VidPavlovic/Diplomski/Tehnicki_crtezi/2-VP-DIP-00-01-01-01-00.pdf

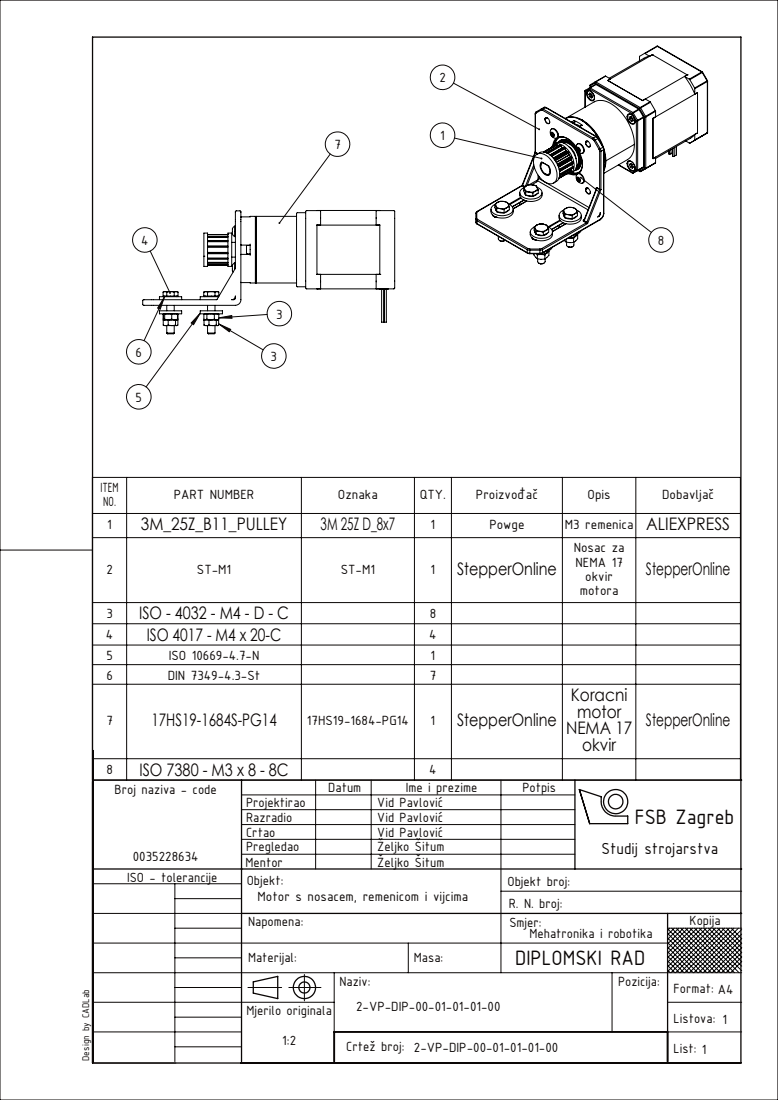
[picture p1: page 1]
Mehatronika i robotika; R. N. broj:

ITEM NO. | PART NUMBER | Oznaka | QTY. | Proizvođač | Opis | Dobavljač
1 | 3M_25Z_B11_PULLEY | 3M 25Z D_8x7 | 1 | Powge | M3 remenica | ALIEXPRESS
2 | ST-M1 | ST-M1 | 1 | StepperOnline | Nosac za NEMA 17 okvir motora | StepperOnline

3 | ISO - 4032 - M4 - D - C | | 8
4 | ISO 4017 - M4 x 20-C | | 4
5 | ISO 10669-4.7-N | | 1
6 | DIN 7349-4.3-St | | 7
7 | 17HS19-1684S-PG14 | 17HS19-1684-PG14 | 1 | StepperOnline | Koracni motor NEMA 17 okvir | StepperOnline

8 | ISO 7380 - M3 x 8 - 8C | | 4
Broj naziva - code 0035228634 | | Datum | Ime i prezime | Potpis | Studij strojarstva

Projektirao | | Vid Pavlović
Razradio | | Vid Pavlović | | FSB Zagreb Crtao

Vid Pavlović

Pregledao | | Željko Šitum

Mentor | | Željko Šitum
ISO - tolerancije | Objekt: Motor s nosacem, remenicom i vijcima | | | Objekt broj:

Materijal: | Masa: | DIPLOMSKI RAD

Naziv: 2-VP-DIP-00-01-01-01-00 | Pozicija: | Format: A4

Design by CADLab

Mjerilo originala | | | | Listova: 1
2-VP-DIP-00-01-01-01-00 1:2 Crtež broj: | | List: 1
