VidPavlovic/Diplomski/Tehnicki_crtezi/2-VP-DIP-00-02-02-00.pdf

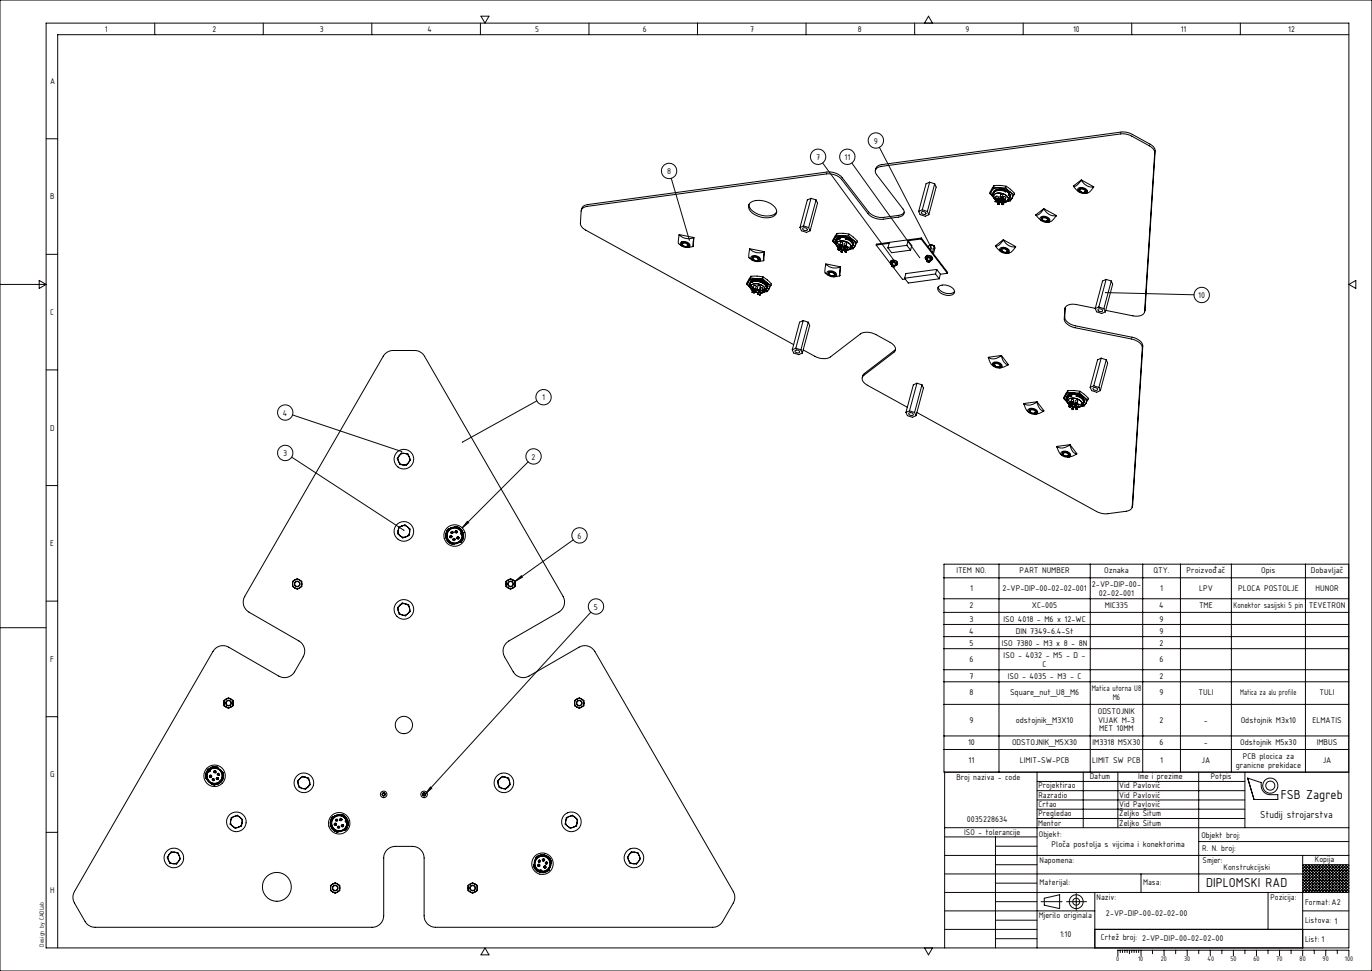
[picture p2: page 1]
Crtež broj:

ITEM NO. | 2-VP-DIP-00-02-02-001 PART NUMBER | 2-VP-DIP-00-Oznaka | QTY. | Proizvođač | Opis | Dobavljač 1

02-02-001 | 1 | LPV | PLOCA POSTOLJE | HUNOR

2 | XC-005 | MIC335 | 4 | TME | Konektor sasijski 5 pin | TEVETRON
3 | ISO 4018 - M6 x 12-WC | | 9
4 | DIN 7349-6.4-St | | 9
5 | ISO 7380 - M3 x 8 - 8N | | 2
6 | ISO - 4032 - M5 - D - C | | 6

7 | ISO - 4035 - M3 - C | | 2
8 | Square_nut_U8_M6 | Matica utorna U8 M6 | 9 | TULI | Matica za alu profile | TULI

9 | odstojnik_M3X10 | ODSTOJNIK VIJAK M-3 MET 10MM | 2 | - | Odstojnik M3x10 | ELMATIS

10 | ODSTOJNIK_M5X30 | IM3318 M5X30 | 6 | - | Odstojnik M5x30 | IMBUS
11 | LIMIT-SW-PCB | LIMIT SW PCB | 1 | JA | PCB plocica za granicne prekidace | JA
Broj naziva - code 0035228634 | Datum Ime i prezime Potpis Projektirao Vid Pavlović Razradio Vid Pavlović Crtao Vid Pavlović Pregledao Željko Šitum Mentor Željko Šitum | FSB Zagreb Studij strojarstva

ISO - tolerancije | Objekt: Objekt broj: Ploča postolja s vijcima i konektorima R. N. broj:

Napomena: Smjer: Konstrukcijski DIPLOMSKI RAD Materijal: Masa: Naziv: Pozicija: 2-VP-DIP-00-02-02-00 Mjerilo originala | Kopija Format: A21 Listova: List: 1

Design by CADLab
