VidPavlovic/Diplomski/Pneumatska_shema/2-VP-DIP-01.pdf

1 | 2 | 3 | 4

A

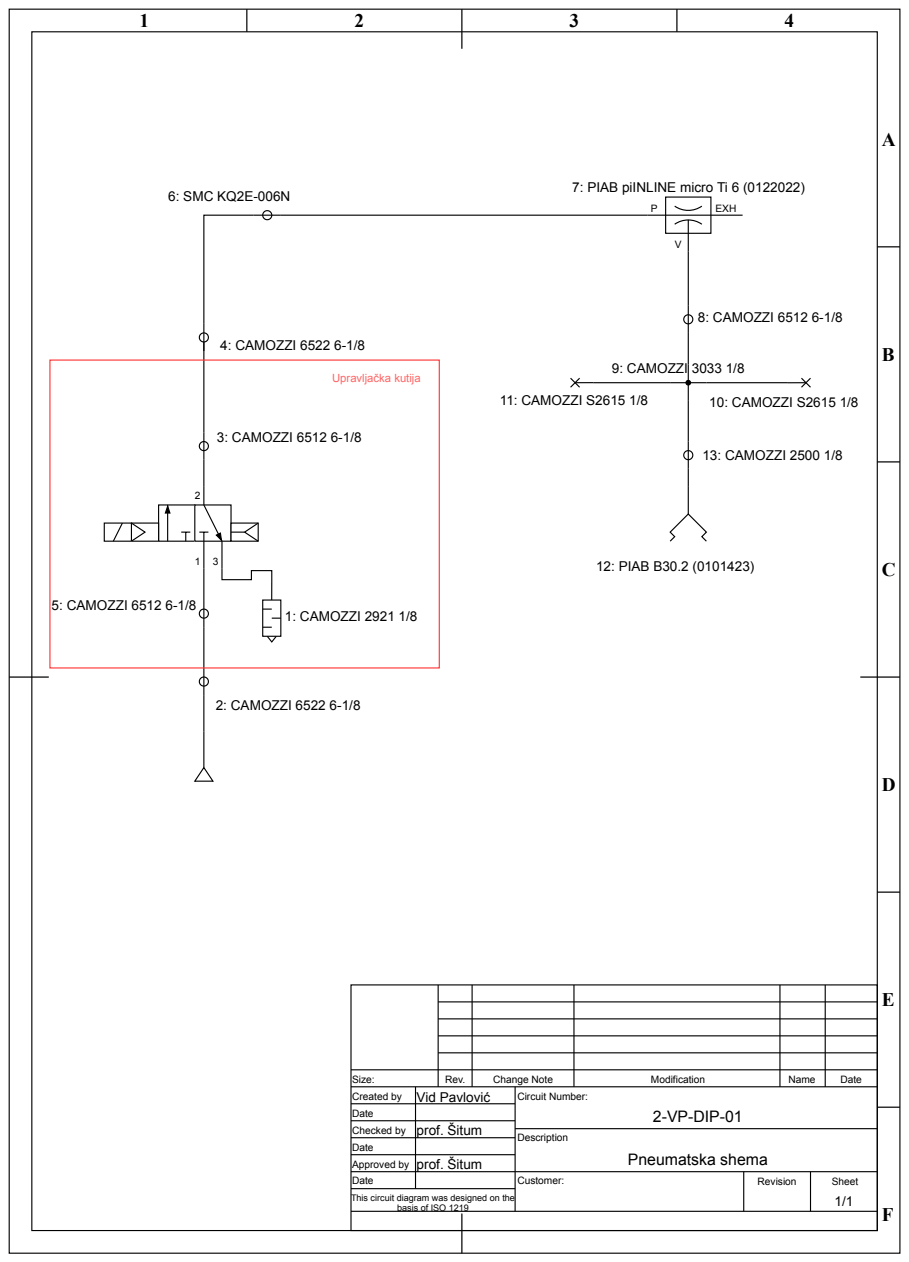
[picture p3: page 1]
Size:; Rev.; Change Note; Modification; Name; Date; Customer:; Description; Circuit Number:; Revision; Sheet; prof. Šitum; Vid Pavlović; Pneumatska shema; 2-VP-DIP-01; 2: CAMOZZI 6522 6-1/8; 5: CAMOZZI 6512 6-1/8; 3: CAMOZZI 6512 6-1/8; 4: CAMOZZI 6522 6-1/8; 6: SMC KQ2E-006N; EXH; 8: CAMOZZI 6512 6-1/8; 12: PIAB B30.2 (0101423); 9: CAMOZZI 3033 1/8; 10: CAMOZZI S2615 1/8; 1: CAMOZZI 2921 1/8; 11: CAMOZZI S2615 1/8; Upravljačka kutija; 13: CAMOZZI 2500 1/8

7: PIAB piINLINE micro Ti 6 (0122022)

Created by
Date
Checked by
Approved by
This circuit diagram was designed on the

basis of ISO 1219
