VidPavlovic/Diplomski/Tehnicki_crtezi/2-VP-DIP-00-01-00.pdf

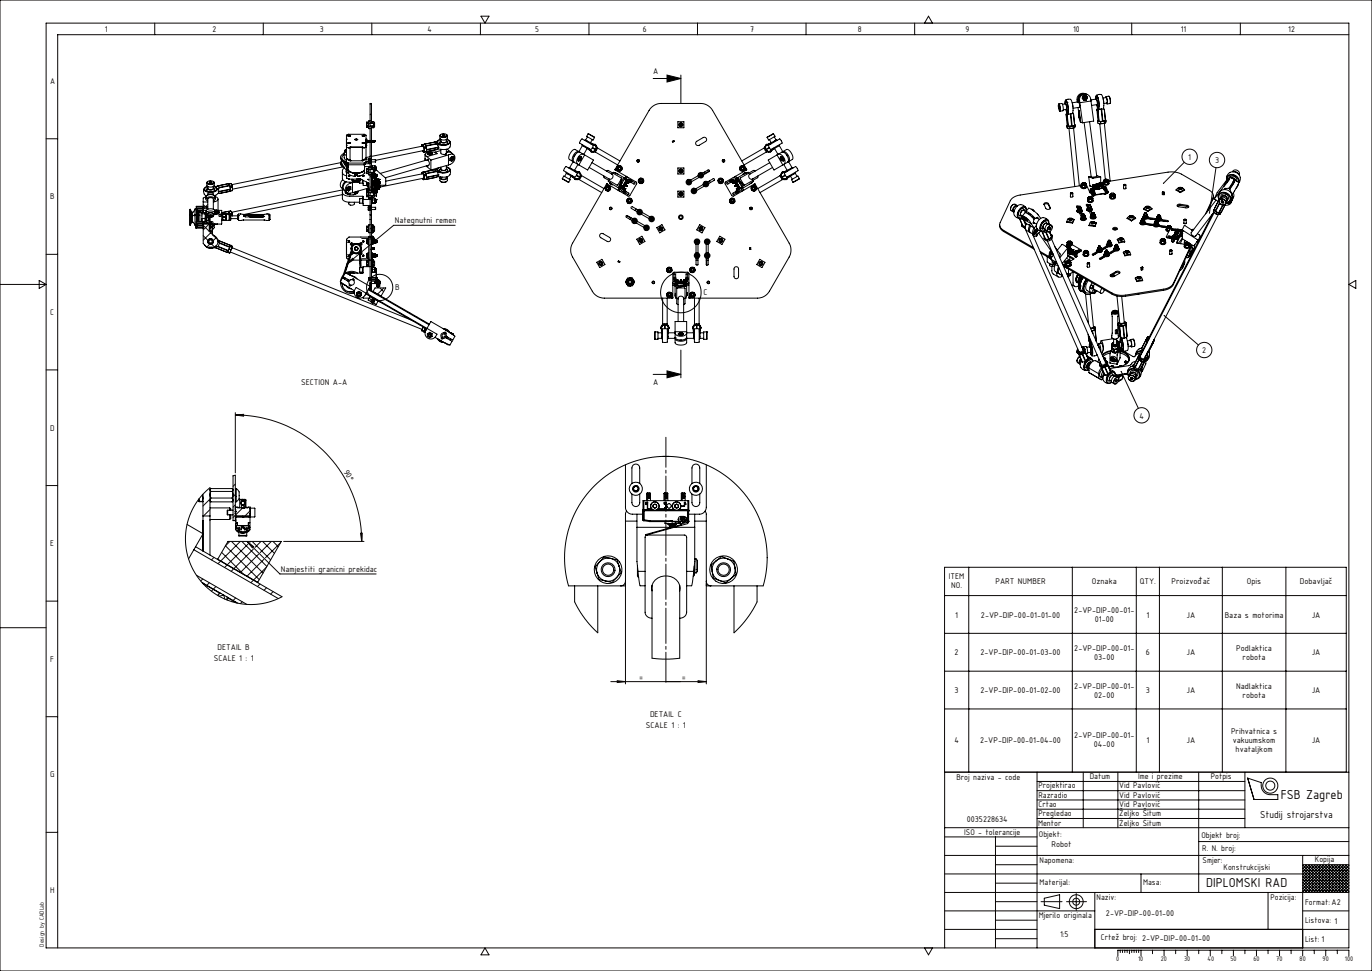
[picture p4: page 1]
SECTION A-A; Nategnutni remen; DETAIL B SCALE 1 : 1; DETAIL C SCALE 1 : 1; Crtež broj:; Mjerilo originala; DIPLOMSKI RAD

Namjestiti granicni prekidac

ITEM NO. | PART NUMBER | Oznaka | QTY. | Proizvođač | Opis | Dobavljač

1 | 2-VP-DIP-00-01-01-00 | 2-VP-DIP-00-01-01-00 | 1 | JA | Baza s motorima | JA

2 | 2-VP-DIP-00-01-03-00 | 2-VP-DIP-00-01-03-00 | 6 | JA | Podlaktica robota | JA

3 | 2-VP-DIP-00-01-02-00 | 2-VP-DIP-00-01-02-00 | 3 | JA | Nadlaktica robota | JA

4 | 2-VP-DIP-00-01-04-00 | 2-VP-DIP-00-01-04-00 | 1 | JA | Prihvatnica s vakuumskom hvataljkom | JA

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

ISO - tolerancije | Objekt: Objekt broj: Robot R. N. broj:

Design by CADLab
