VidPavlovic/Diplomski/Tehnicki_crtezi/2-VP-DIP-00-01-01-00.pdf

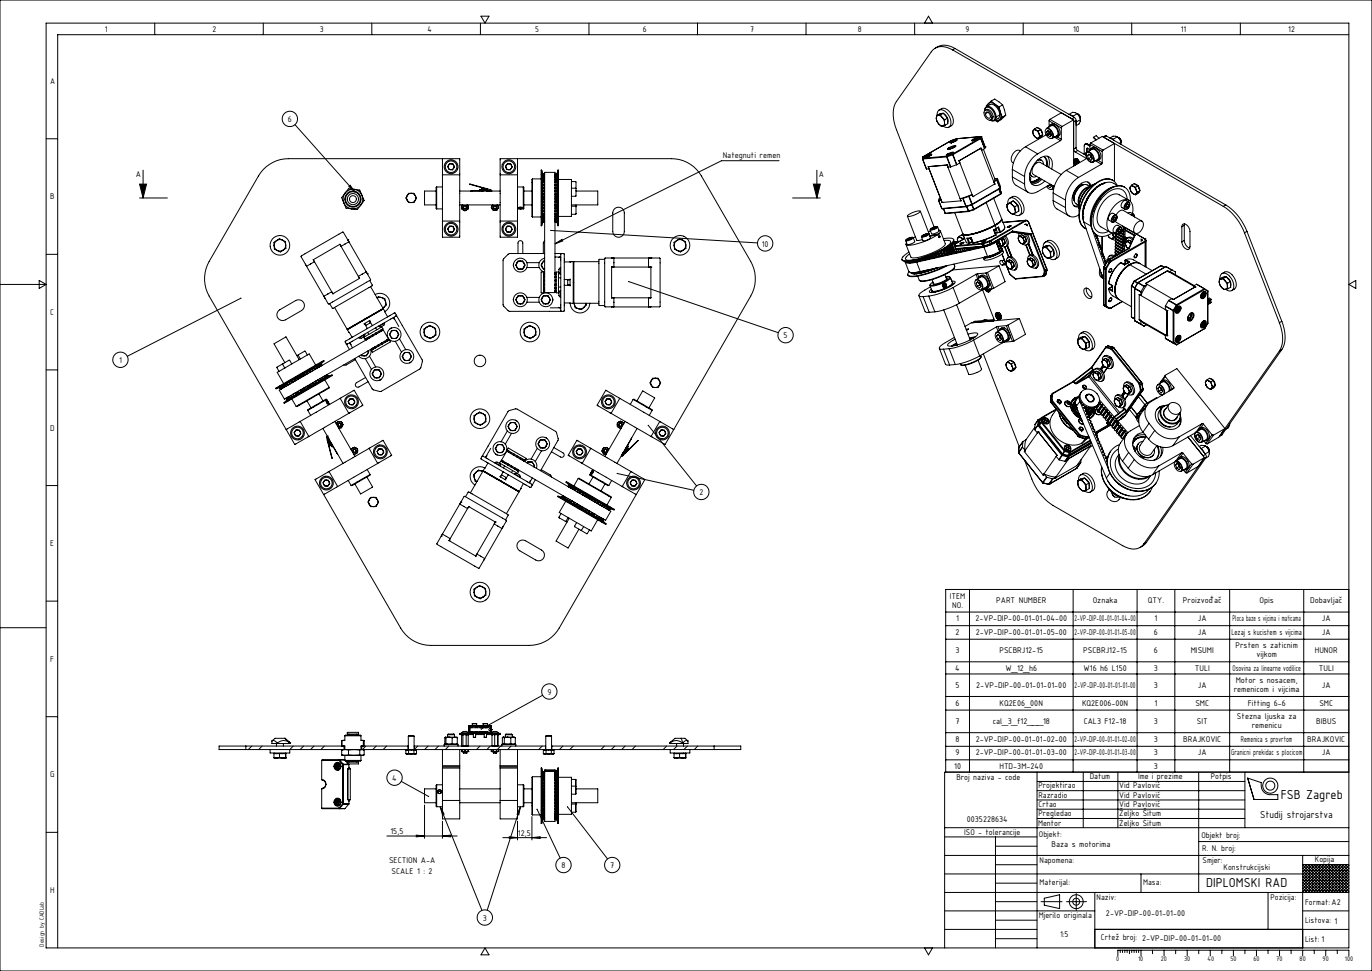
[picture p5: page 1]
Nategnuti remen; SECTION A-A SCALE 1 : 2; Crtež broj:; Mjerilo originala; DIPLOMSKI RAD

ITEM NO. | PART NUMBER | Oznaka | QTY. | Proizvođač | Opis | Dobavljač

1 | 2-VP-DIP-00-01-01-04-00 | 2-VP-DIP-00-01-01-04-00 | 1 | JA | Ploca baze s vijcima i maticama | JA
2 | 2-VP-DIP-00-01-01-05-00 | 2-VP-DIP-00-01-01-05-00 | 6 | JA | Lezaj s kucistem s vijcima | JA
3 | PSCBRJ12-15 | PSCBRJ12-15 | 6 | MISUMI | Prsten s zaticnim vijkom | HUNOR

4 | W_12_h6 | W16 h6 L150 | 3 | TULI | Osovina za linearne vodilice | TULI
5 | 2-VP-DIP-00-01-01-01-00 | 2-VP-DIP-00-01-01-01-00 | 3 | JA | Motor s nosacem, remenicom i vijcima | JA

6 | KQ2E06_00N | KQ2E006-00N | 1 | SMC | Fitting 6-6 | SMC
7 | cal_3_f12___18 | CAL3 F12-18 | 3 | SIT | Stezna ljuska za remenicu | BIBUS

8 | 2-VP-DIP-00-01-01-02-00 | 2-VP-DIP-00-01-01-02-00 | 3 | BRAJKOVIC | Remenica s provrtom | BRAJKOVIC
9 | 2-VP-DIP-00-01-01-03-00 | 2-VP-DIP-00-01-01-03-00 | 3 | JA | Granicni prekidac s plocicom | JA
10 | HTD-3M-240 | | 3
Broj naziva - code 0035228634 | Datum Ime i prezime Potpis Projektirao Vid Pavlović Razradio Vid Pavlović Crtao Vid Pavlović Pregledao Željko Šitum Mentor Željko Šitum | FSB Zagreb Studij strojarstva

ISO - tolerancije | Objekt: Objekt broj: Baza s motorima R. N. broj:

Design by CADLab
