VidPavlovic/Diplomski/Tehnicki_crtezi/2-VP-DIP-00-01-01-02-00.pdf

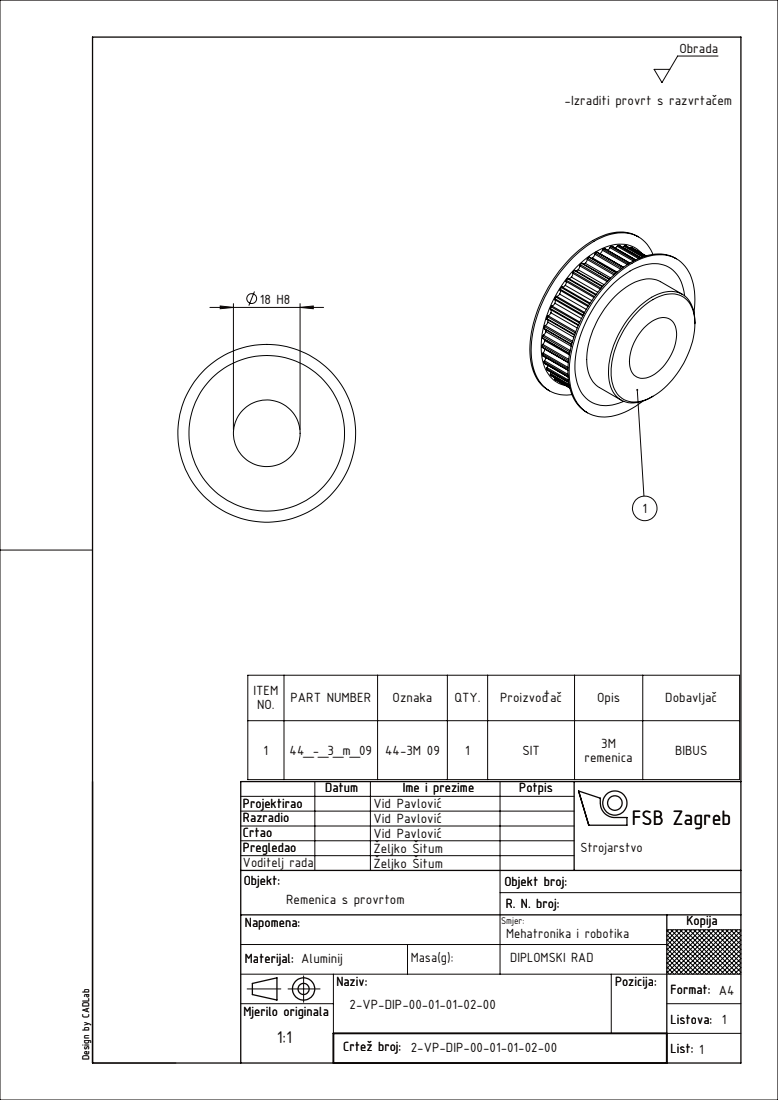
[picture p6: page 1]
R. N. broj:; Mehatronika i robotika

-Izraditi provrt s razvrtačem

ITEM NO. | PART NUMBER | Oznaka | QTY. | Proizvođač | Opis | Dobavljač

1 | 44_-_3_m_09 | 44-3M 09 | 1 | SIT | 3M remenica | BIBUS

Datum | Ime i prezime | Potpis | FSB Zagreb FSB Zagreb Strojarstvo
Projektirao | | Vid Pavlović
Razradio | | Vid Pavlović
Crtao | | Vid Pavlović
Pregledao | | Željko Šitum
Voditelj rada | | Željko Šitum
Objekt: Objekt: Remenica s provrtom | | | Objekt broj:

Materijal: Materijal: Aluminij | Masa(g): | DIPLOMSKI RAD

Naziv: Naziv: 2-VP-DIP-00-01-01-02-00 | Pozicija: | Format: Format: A4

Design by CADLab

Mjerilo originala | | | | Listova: Listova: 1
2-VP-DIP-00-01-01-02-00 1:1 Crtež broj: Crtež broj: | | List: List: 1
