VidPavlovic/Diplomski/Tehnicki_crtezi/2-VP-DIP-00-01-01-03-00.pdf

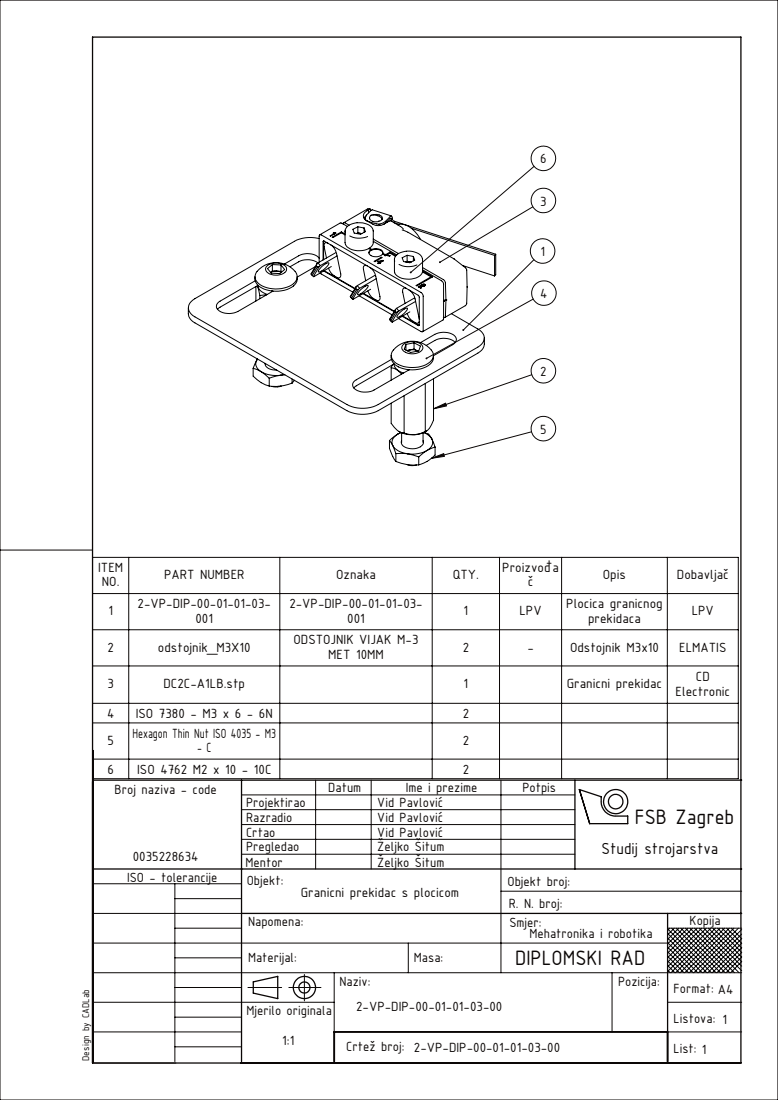
[picture p7: page 1]
Mehatronika i robotika; R. N. broj:

ITEM NO. | PART NUMBER | Oznaka | QTY. | Proizvođa č | Opis | Dobavljač

1 | 2-VP-DIP-00-01-01-03-001 | 2-VP-DIP-00-01-01-03-001 | 1 | LPV | Plocica granicnog prekidaca | LPV

2 | odstojnik_M3X10 | ODSTOJNIK VIJAK M-3 MET 10MM | 2 | - | Odstojnik M3x10 | ELMATIS

3 | DC2C-A1LB.stp | | 1 | | Granicni prekidac | CD Electronic

4 | ISO 7380 - M3 x 6 - 6N | | 2
5 | Hexagon Thin Nut ISO 4035 - M3 - C | | 2

6 | ISO 4762 M2 x 10 - 10C | | 2
Broj naziva - code 0035228634 | | Datum | Ime i prezime | Potpis | Studij strojarstva

Projektirao | | Vid Pavlović
Razradio | | Vid Pavlović | | FSB Zagreb Crtao

Vid Pavlović

Pregledao | | Željko Šitum

Mentor | | Željko Šitum
ISO - tolerancije | Objekt: Granicni prekidac s plocicom | | | Objekt broj:

Materijal: | Masa: | DIPLOMSKI RAD

Naziv: 2-VP-DIP-00-01-01-03-00 | Pozicija: | Format: A4

Design by CADLab

Mjerilo originala | | | | Listova: 1
2-VP-DIP-00-01-01-03-00 1:1 Crtež broj: | | List: 1
