VidPavlovic/Diplomski/Tehnicki_crtezi/2-VP-DIP-00-01-01-04-00.pdf

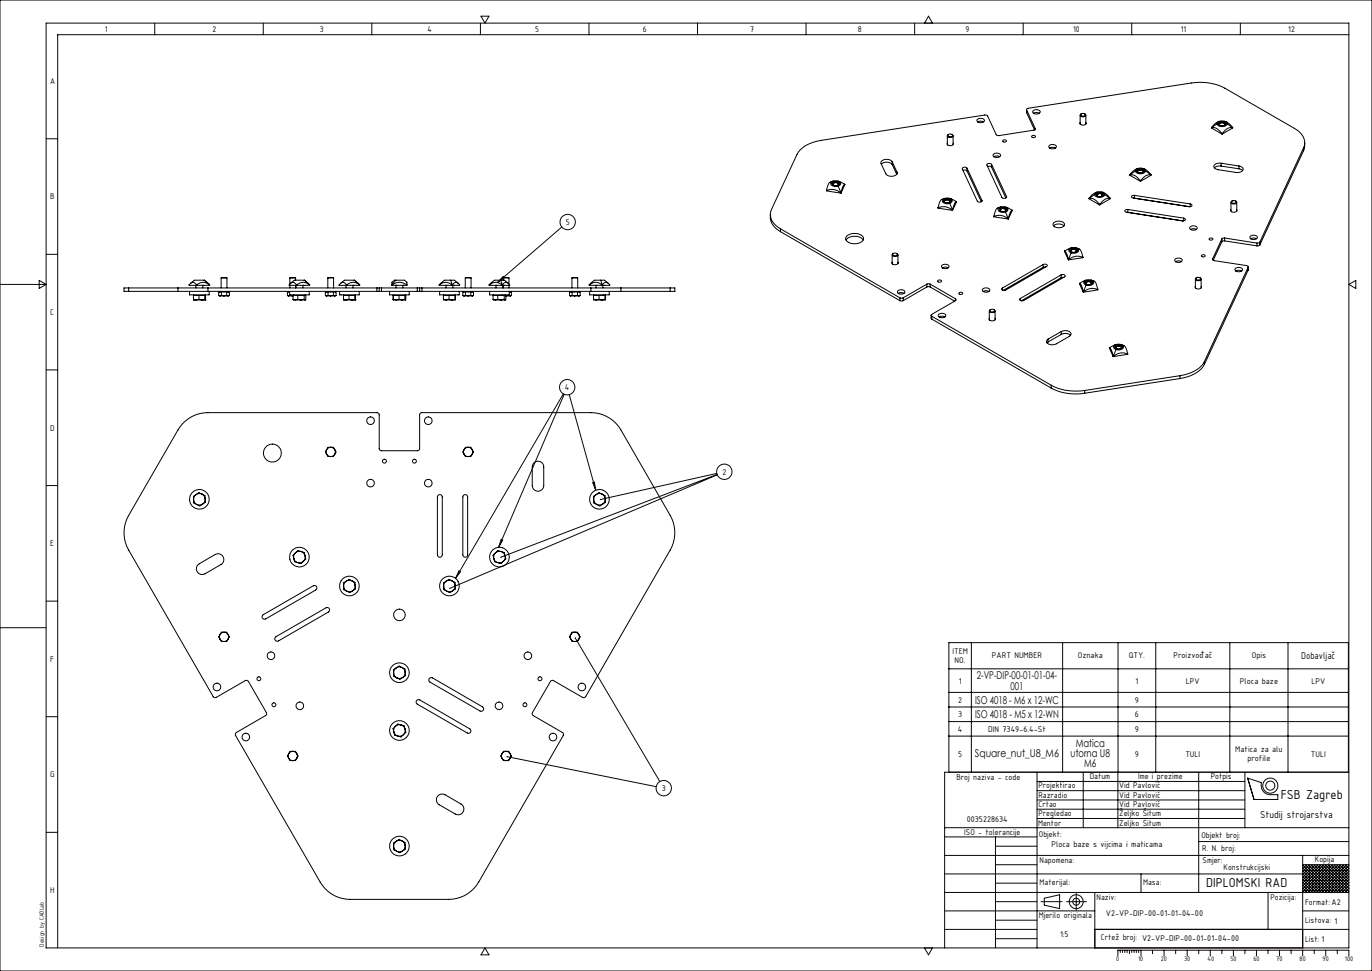
[picture p9: page 1]
Crtež broj:; Mjerilo originala; DIPLOMSKI RAD

ITEM NO. | PART NUMBER | Oznaka | QTY. | Proizvođač | Opis | Dobavljač
1 | 2-VP-DIP-00-01-01-04-001 | | 1 | LPV | Ploca baze | LPV
2 | ISO 4018 - M6 x 12-WC | | 9
3 | ISO 4018 - M5 x 12-WN | | 6
4 | DIN 7349-6.4-St | | 9
5 | Square_nut_U8_M6 | Matica utorna U8 M6 | 9 | TULI | Matica za alu profile | TULI

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

ISO - tolerancije | Objekt: Objekt broj: Ploca baze s vijcima i maticama R. N. broj:

Design by CADLab
