VidPavlovic/Diplomski/Tehnicki_crtezi/2-VP-DIP-00-01-01-04-001.pdf

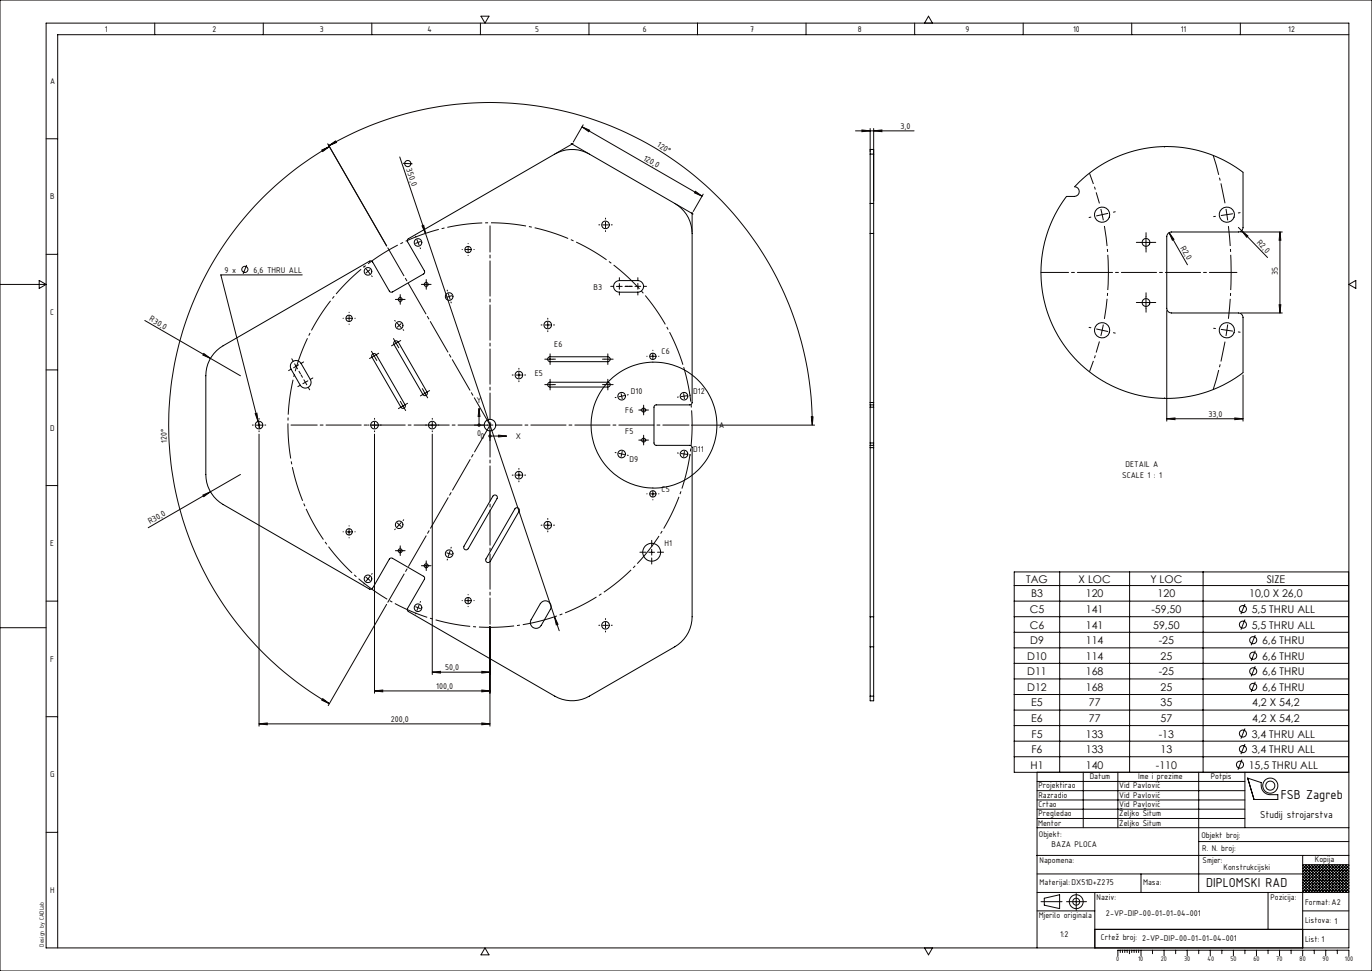
[picture p10: page 1]
6,6 THRU ALL; DETAIL A SCALE 1 : 1; Crtež broj:; R. N. broj:; Objekt broj:; Mjerilo originala; DIPLOMSKI RAD; BAZA PLOCA

TAG | X LOC | Y LOC | SIZE
B3 | 120 | 120 | 10,0 X 26,0
C5 | 141 | -59,50 | 5,5 THRU ALL
C6 | 141 | 59,50 | 5,5 THRU ALL
D9 | 114 | -25 | 6,6 THRU
D10 | 114 | 25 | 6,6 THRU
D11 | 168 | -25 | 6,6 THRU
D12 | 168 | 25 | 6,6 THRU
E5 | 77 | 35 | 4,2 X 54,2
E6 | 77 | 57 | 4,2 X 54,2
F5 | 133 | -13 | 3,4 THRU ALL
F6 | 133 | 13 | 3,4 THRU ALL
H1 | 140 | -110 | 15,5 THRU ALL
Datum Ime i prezime Potpis Projektirao Vid Pavlović Razradio Vid Pavlović Crtao Vid Pavlović Pregledao Željko Šitum Mentor Željko Šitum | FSB Zagreb Studij strojarstva

Design by CADLab
