VidPavlovic/Diplomski/Tehnicki_crtezi/2-VP-DIP-00-01-01-05-00.pdf

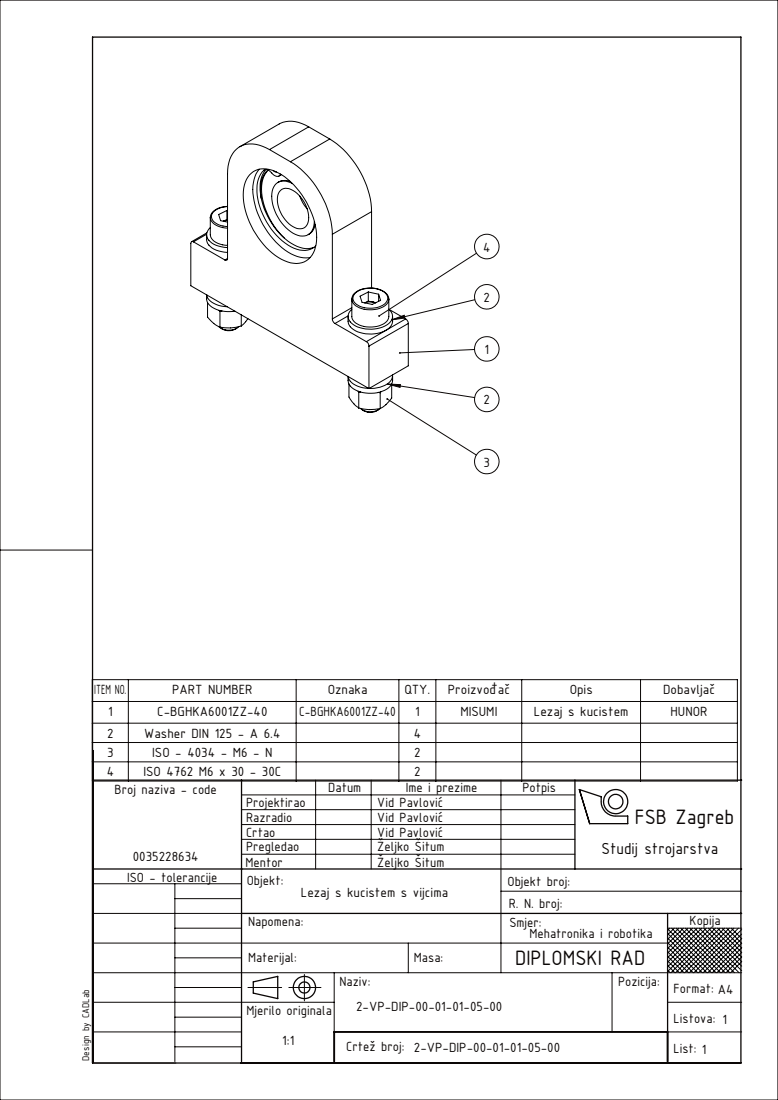
[picture p11: page 1]
Mehatronika i robotika; R. N. broj:

ITEM NO. | PART NUMBER | Oznaka | QTY. | Proizvođač | Opis | Dobavljač
1 | C-BGHKA6001ZZ-40 | C-BGHKA6001ZZ-40 | 1 | MISUMI | Lezaj s kucistem | HUNOR
2 | Washer DIN 125 - A 6.4 | | 4
3 | ISO - 4034 - M6 - N | | 2
4 | ISO 4762 M6 x 30 - 30C | | 2
Broj naziva - code 0035228634 | | Datum | Ime i prezime | Potpis | Studij strojarstva

Projektirao | | Vid Pavlović
Razradio | | Vid Pavlović | | FSB Zagreb Crtao

Vid Pavlović

Pregledao | | Željko Šitum

Mentor | | Željko Šitum
ISO - tolerancije | Objekt: Lezaj s kucistem s vijcima | | | Objekt broj:

Materijal: | Masa: | DIPLOMSKI RAD

Naziv: 2-VP-DIP-00-01-01-05-00 | Pozicija: | Format: A4

Design by CADLab

Mjerilo originala | | | | Listova: 1
2-VP-DIP-00-01-01-05-00 1:1 Crtež broj: | | List: 1
