VidPavlovic/Diplomski/Tehnicki_crtezi/2-VP-DIP-00-01-02-00.pdf

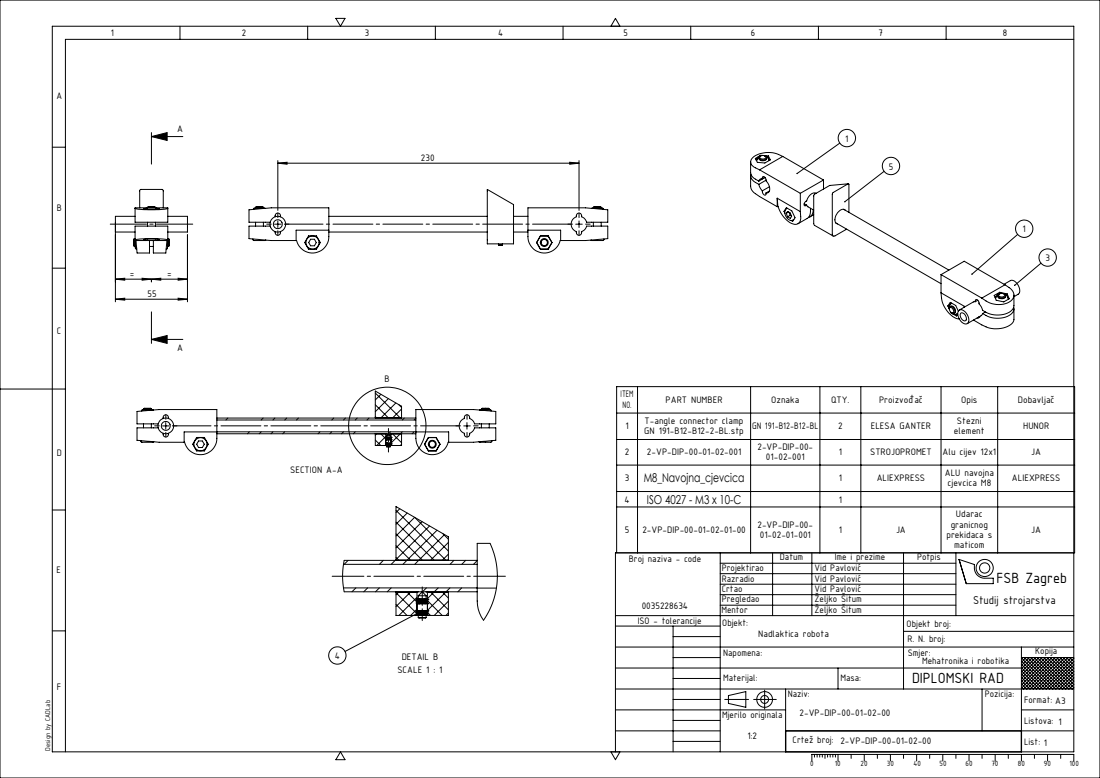
[picture p12: page 1]
SECTION A-A; DETAIL B SCALE 1 : 1; Crtež broj:

ITEM NO. | PART NUMBER | Oznaka | QTY. | Proizvođač | Opis | Dobavljač

1 | GN 191-B12-B12-2-BL.stp T-angle connector clamp | GN 191-B12-B12-BL | 2 | ELESA GANTER | Stezni element | HUNOR

2 | 2-VP-DIP-00-01-02-001 | 2-VP-DIP-00-01-02-001 | 1 | STROJOPROMET | Alu cijev 12x1 | JA

3 | M8_Navojna_cjevcica | | 1 | ALIEXPRESS | ALU navojna cjevcica M8 | ALIEXPRESS
4 | ISO 4027 - M3 x 10-C | | 1
5 | 2-VP-DIP-00-01-02-01-00 | 2-VP-DIP-00-01-02-01-001 | 1 | JA | Udarac granicnog prekidaca s maticom | JA

Broj naziva - code | Datum Ime i prezime Potpis Projektirao Vid Pavlović Razradio Vid Pavlović Crtao Vid Pavlović Pregledao Željko Šitum Željko Šitum 0035228634 Mentor | FSB Zagreb Studij strojarstva

ISO - tolerancije | Objekt: Objekt broj: Nadlaktica robota R. N. broj:

Napomena: Smjer: Mehatronika i robotika DIPLOMSKI RAD Materijal: Masa: Naziv: Pozicija: 2-VP-DIP-00-01-02-00 Mjerilo originala | Kopija Format: A3 Listova: 1 List: 1

Design by CADLab
