VidPavlovic/Diplomski/Tehnicki_crtezi/2-VP-DIP-00-01-02-01-00.pdf

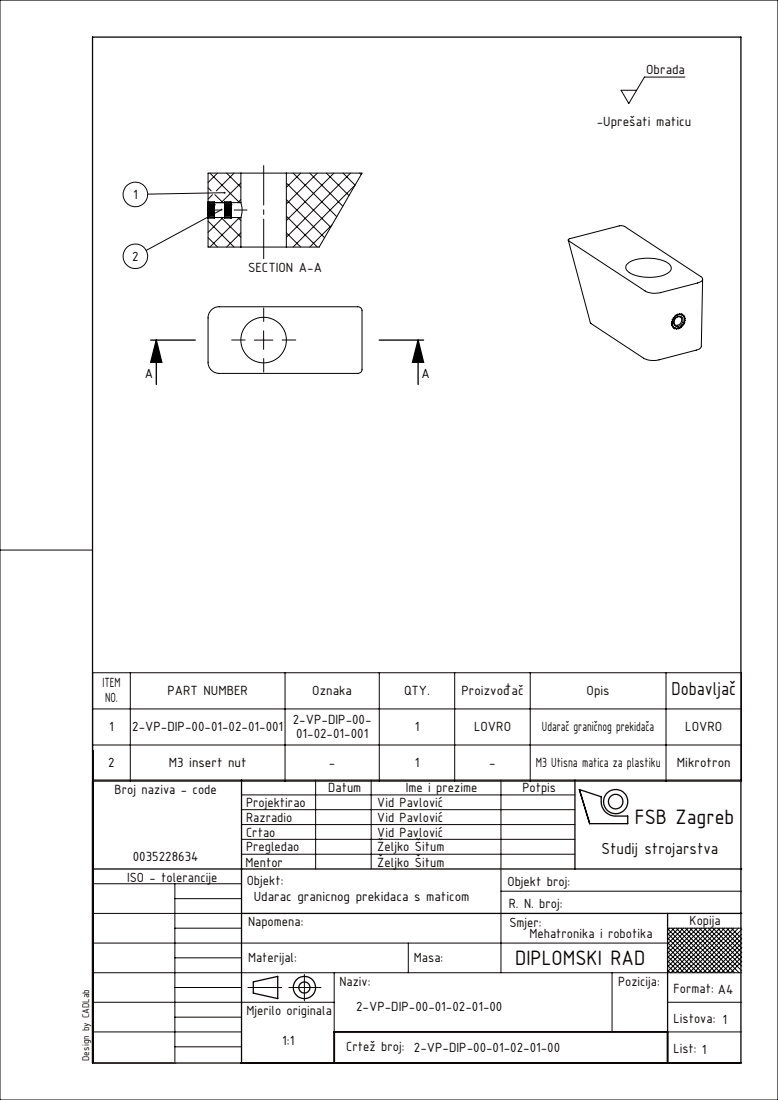
[picture p13: page 1]
SECTION A-A; -Uprešati maticu; Mehatronika i robotika; R. N. broj:

ITEM NO. | PART NUMBER | Oznaka | QTY. | Proizvođač | Opis | Dobavljač

1 | 2-VP-DIP-00-01-02-01-001 | 2-VP-DIP-00-01-02-01-001 | 1 | LOVRO | Udarač graničnog prekidača | LOVRO

2 | M3 insert nut | - | 1 | - | M3 Utisna matica za plastiku | Mikrotron
Broj naziva - code 0035228634 | | Datum | Ime i prezime | Potpis | Studij strojarstva

Projektirao | | Vid Pavlović
Razradio | | Vid Pavlović | | FSB Zagreb Crtao

Vid Pavlović

Pregledao | | Željko Šitum

Mentor | | Željko Šitum
ISO - tolerancije | Objekt: Udarac granicnog prekidaca s maticom | | | Objekt broj:

Materijal: | Masa: | DIPLOMSKI RAD

Naziv: 2-VP-DIP-00-01-02-01-00 | Pozicija: | Format: A4

Design by CADLab

Mjerilo originala | | | | Listova: 1
2-VP-DIP-00-01-02-01-00 1:1 Crtež broj: | | List: 1
