VidPavlovic/Diplomski/Tehnicki_crtezi/2-VP-DIP-00-01-02-01-001.pdf

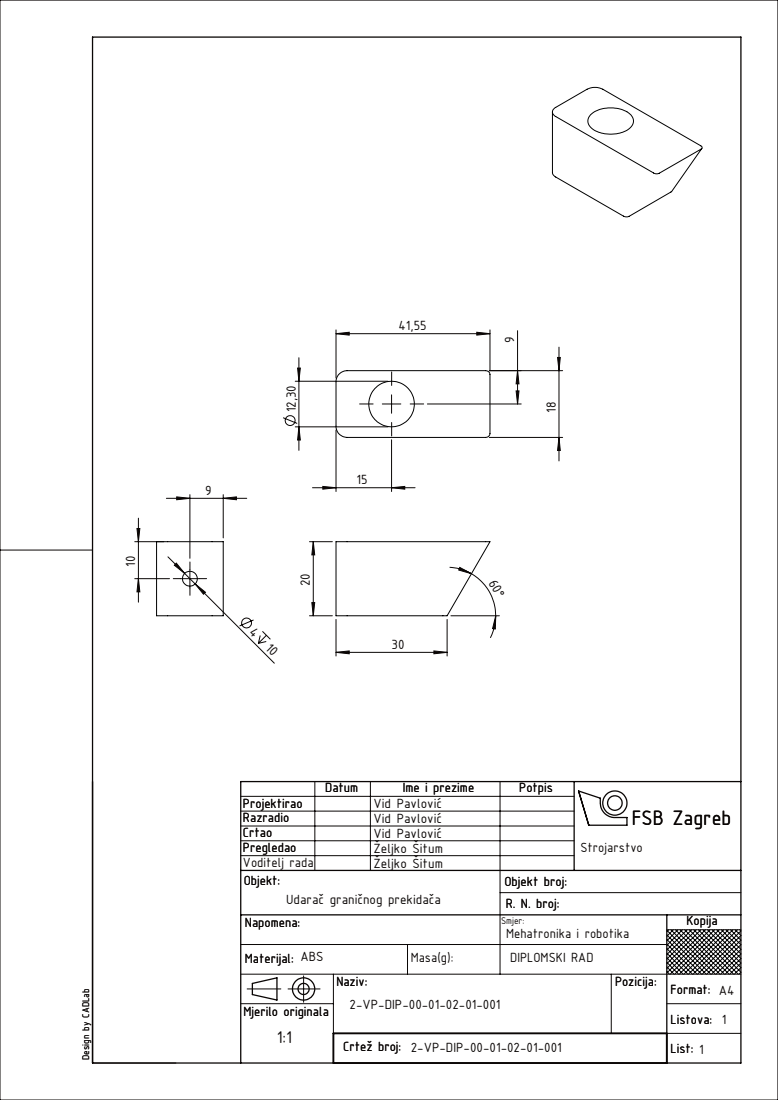
[picture p14: page 1]
R. N. broj:; Mehatronika i robotika

Datum | Ime i prezime | Potpis | FSB Zagreb FSB Zagreb Strojarstvo
Projektirao | | Vid Pavlović
Razradio | | Vid Pavlović
Crtao | | Vid Pavlović
Pregledao | | Željko Šitum
Voditelj rada | | Željko Šitum
Objekt: Objekt: Udarač graničnog prekidača | | | Objekt broj:

Materijal: Materijal: ABS | Masa(g): | DIPLOMSKI RAD

Naziv: Naziv: 2-VP-DIP-00-01-02-01-001 | Pozicija: | Format: Format: A4

Design by CADLab

Mjerilo originala | | | | Listova: Listova: 1
2-VP-DIP-00-01-02-01-001 1:1 Crtež broj: Crtež broj: | | List: List: 1
