VidPavlovic/Diplomski/Tehnicki_crtezi/2-VP-DIP-00-01-03-00.pdf

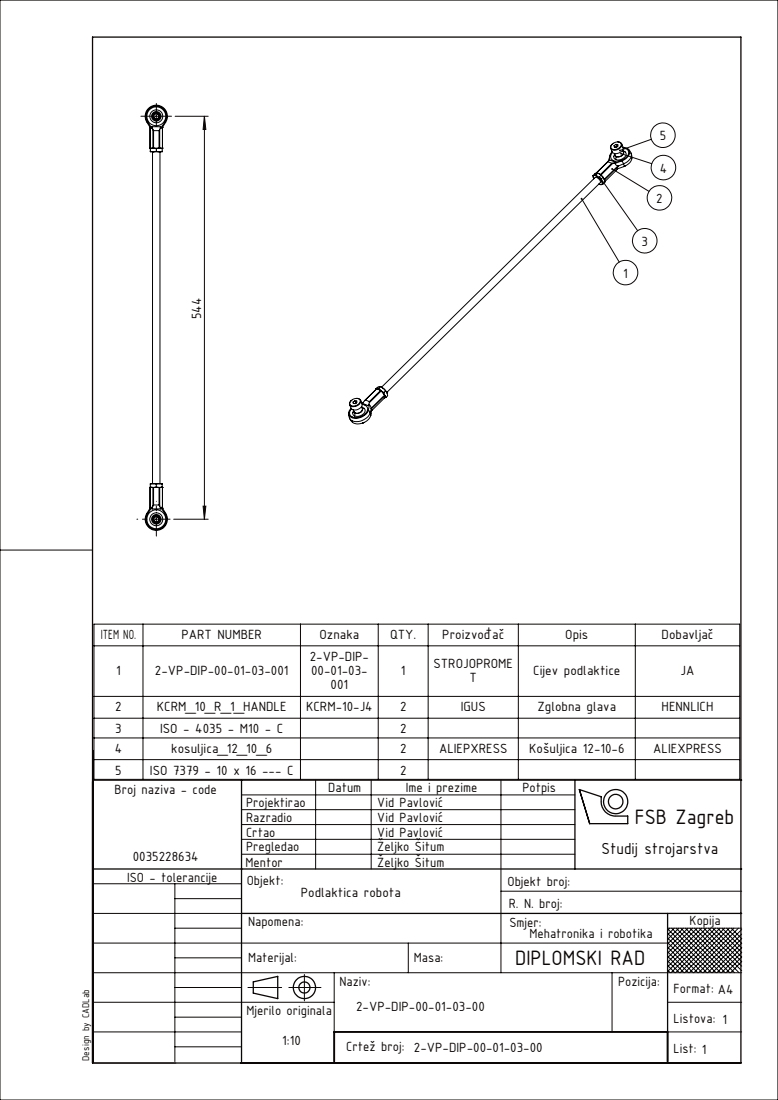
[picture p15: page 1]
Mehatronika i robotika; R. N. broj:

ITEM NO. | PART NUMBER | Oznaka | QTY. | Proizvođač | Opis | Dobavljač
1 | 2-VP-DIP-00-01-03-001 | 2-VP-DIP-00-01-03-001 | 1 | STROJOPROME T | Cijev podlaktice | JA

2 | KCRM_10_R_1_HANDLE | KCRM-10-J4 | 2 | IGUS | Zglobna glava | HENNLICH
3 | ISO - 4035 - M10 - C | | 2
4 | kosuljica_12_10_6 | | 2 | ALIEPXRESS | Košuljica 12-10-6 | ALIEXPRESS
5 | ISO 7379 - 10 x 16 --- C | | 2
Broj naziva - code 0035228634 | | Datum | Ime i prezime | Potpis | Studij strojarstva

Projektirao | | Vid Pavlović
Razradio | | Vid Pavlović | | FSB Zagreb Crtao

Vid Pavlović

Pregledao | | Željko Šitum

Mentor | | Željko Šitum
ISO - tolerancije | Objekt: Podlaktica robota | | | Objekt broj:

Materijal: | Masa: | DIPLOMSKI RAD

Naziv: 2-VP-DIP-00-01-03-00 | Pozicija: | Format: A4

Design by CADLab

Mjerilo originala | | | | Listova: 1
2-VP-DIP-00-01-03-00 1:10 Crtež broj: | | List: 1
