VidPavlovic/Diplomski/Tehnicki_crtezi/2-VP-DIP-00-01-03-001.pdf

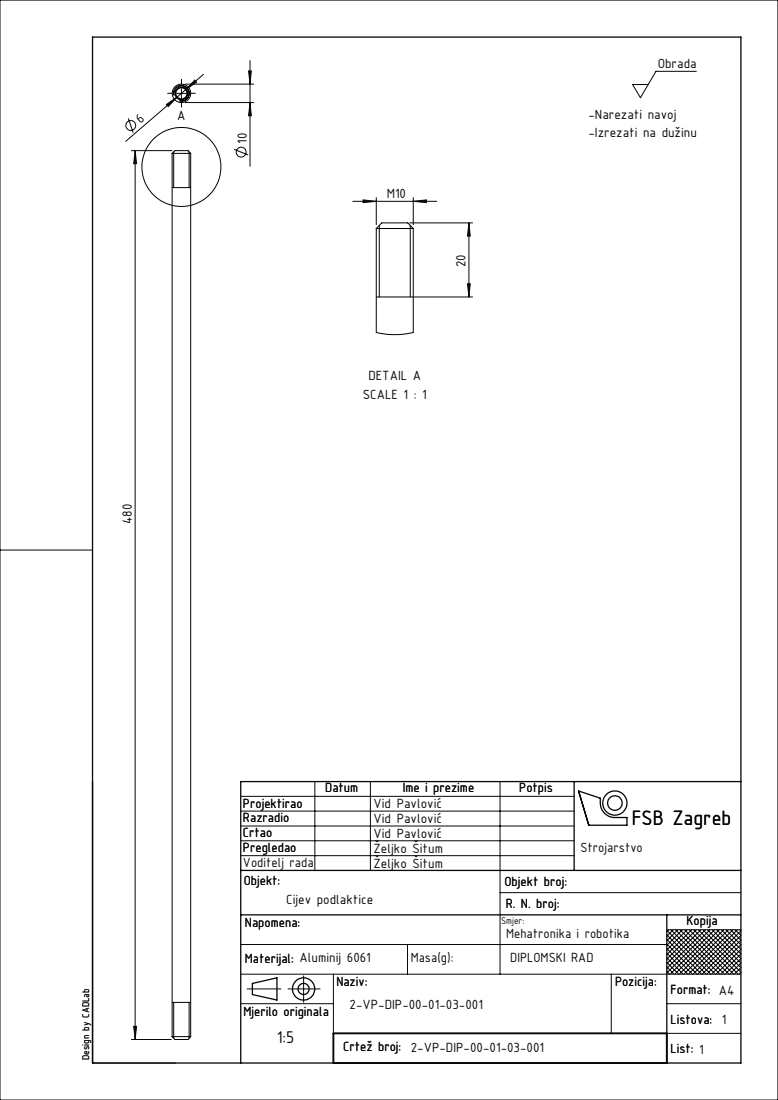
[picture p16: page 1]
DETAIL A SCALE 1 : 1; R. N. broj:; Mehatronika i robotika

-Narezati navoj
-Izrezati na dužinu

Datum | Ime i prezime | Potpis | FSB Zagreb FSB Zagreb Strojarstvo
Projektirao | | Vid Pavlović
Razradio | | Vid Pavlović
Crtao | | Vid Pavlović
Pregledao | | Željko Šitum
Voditelj rada | | Željko Šitum
Objekt: Objekt: Cijev podlaktice | | | Objekt broj:

Materijal: Materijal: Aluminij 6061 | Masa(g): | DIPLOMSKI RAD

Naziv: Naziv: 2-VP-DIP-00-01-03-001 | Pozicija: | Format: Format: A4

Design by CADLab

Mjerilo originala | | | | Listova: Listova: 1
2-VP-DIP-00-01-03-001 1:5 Crtež broj: Crtež broj: | | List: List: 1
