VidPavlovic/Diplomski/Tehnicki_crtezi/2-VP-DIP-00-01-04-00.pdf

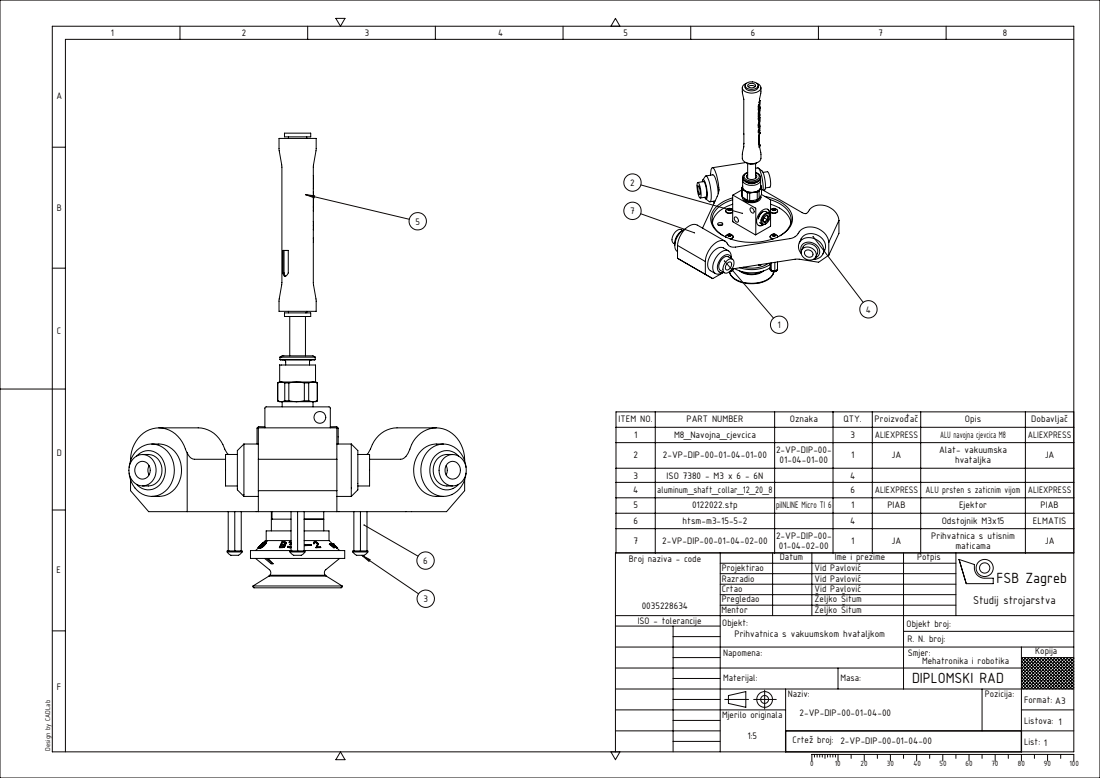
[picture p17: page 1]
Crtež broj:

ITEM NO. | PART NUMBER | Oznaka | QTY. | Proizvođač | Opis | Dobavljač
1 | M8_Navojna_cjevcica | | 3 | ALIEXPRESS | ALU navojna cjevcica M8 | ALIEXPRESS
2 | 2-VP-DIP-00-01-04-01-00 | 2-VP-DIP-00-01-04-01-00 | 1 | JA | Alat- vakuumska hvataljka | JA

3 | ISO 7380 - M3 x 6 - 6N | | 4
4 | aluminum_shaft_collar_12_20_8 | | 6 | ALIEXPRESS | ALU prsten s zaticnim vijom | ALIEXPRESS
5 | 0122022.stp | piINLINE Micro TI 6 | 1 | PIAB | Ejektor | PIAB
6 | htsm-m3-15-5-2 | | 4 | | Odstojnik M3x15 | ELMATIS
7 | 2-VP-DIP-00-01-04-02-00 | 2-VP-DIP-00-01-04-02-00 | 1 | JA | Prihvatnica s utisnim maticama | JA
Broj naziva - code | Datum Ime i prezime Potpis Projektirao Vid Pavlović Razradio Vid Pavlović Crtao Vid Pavlović Pregledao Željko Šitum Željko Šitum 0035228634 Mentor | FSB Zagreb Studij strojarstva

ISO - tolerancije | Objekt: Objekt broj: Prihvatnica s vakuumskom hvataljkom R. N. broj:

Napomena: Smjer: Mehatronika i robotika DIPLOMSKI RAD Materijal: Masa: Naziv: Pozicija: 2-VP-DIP-00-01-04-00 Mjerilo originala | Kopija Format: A3 Listova: 1 List: 1

Design by CADLab
