VidPavlovic/Diplomski/Tehnicki_crtezi/2-VP-DIP-00-01-04-01-00.pdf

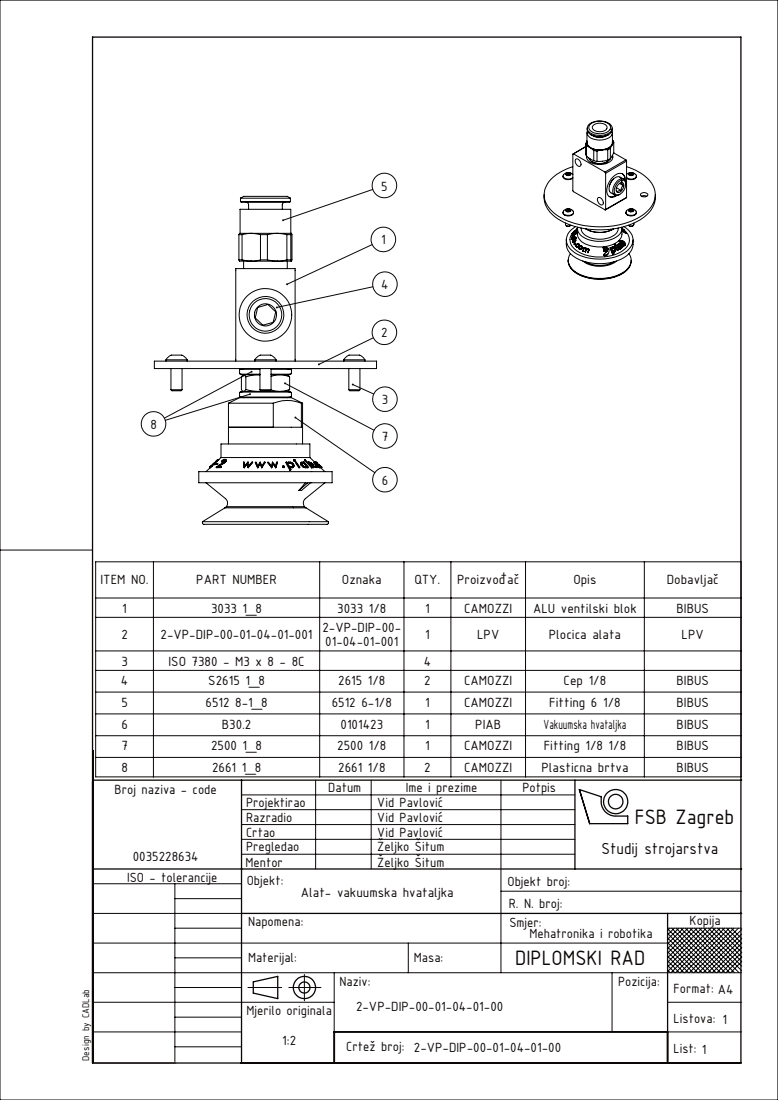
[picture p18: page 1]
Mehatronika i robotika; R. N. broj:

ITEM NO. | PART NUMBER | Oznaka | QTY. | Proizvođač | Opis | Dobavljač
1 | 3033 1_8 | 3033 1/8 | 1 | CAMOZZI | ALU ventilski blok | BIBUS
2 | 2-VP-DIP-00-01-04-01-001 | 2-VP-DIP-00-01-04-01-001 | 1 | LPV | Plocica alata | LPV

3 | ISO 7380 - M3 x 8 - 8C | | 4
4 | S2615 1_8 | 2615 1/8 | 2 | CAMOZZI | Cep 1/8 | BIBUS
5 | 6512 8-1_8 | 6512 6-1/8 | 1 | CAMOZZI | Fitting 6 1/8 | BIBUS
6 | B30.2 | 0101423 | 1 | PIAB | Vakuumska hvataljka | BIBUS
7 | 2500 1_8 | 2500 1/8 | 1 | CAMOZZI | Fitting 1/8 1/8 | BIBUS
8 | 2661 1_8 | 2661 1/8 | 2 | CAMOZZI | Plasticna brtva | BIBUS
Broj naziva - code 0035228634 | | Datum | Ime i prezime | Potpis | Studij strojarstva

Projektirao | | Vid Pavlović
Razradio | | Vid Pavlović | | FSB Zagreb Crtao

Vid Pavlović

Pregledao | | Željko Šitum

Mentor | | Željko Šitum
ISO - tolerancije | Objekt: Alat- vakuumska hvataljka | | | Objekt broj:

Materijal: | Masa: | DIPLOMSKI RAD

Naziv: 2-VP-DIP-00-01-04-01-00 | Pozicija: | Format: A4

Design by CADLab

Mjerilo originala | | | | Listova: 1
2-VP-DIP-00-01-04-01-00 1:2 Crtež broj: | | List: 1
