VidPavlovic/Diplomski/Tehnicki_crtezi/2-VP-DIP-00-01-04-01-001.pdf

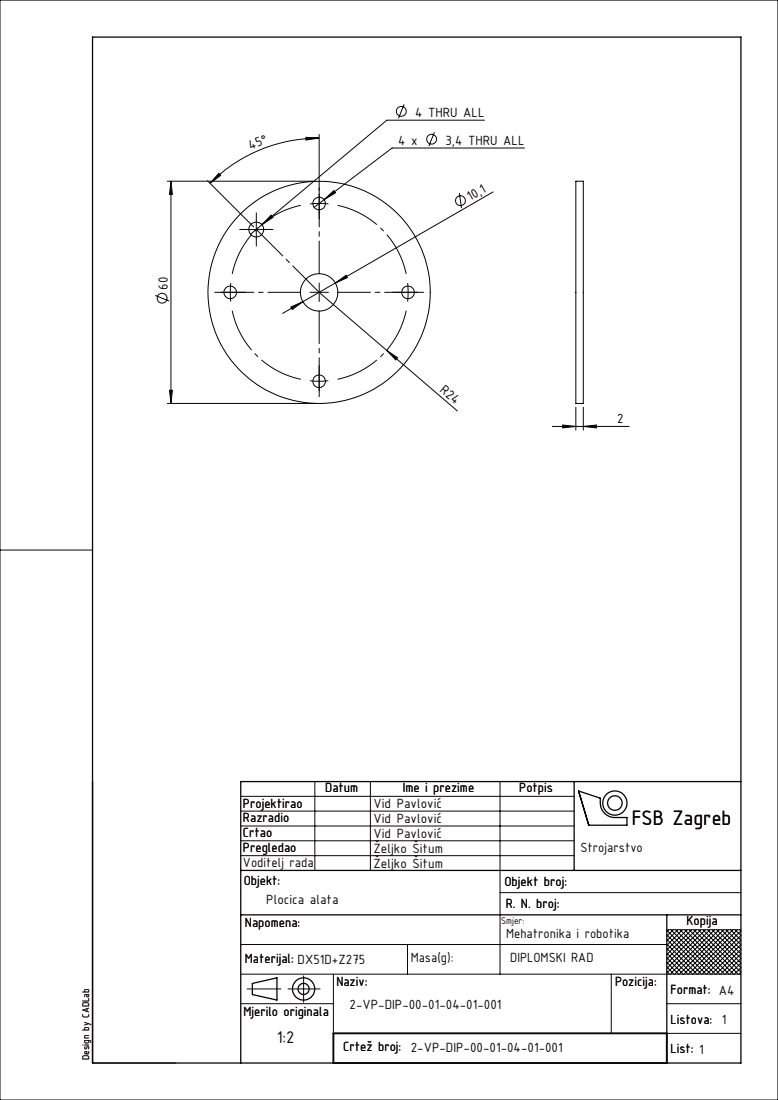
[picture p19: page 1]
3,4 THRU ALL; 4 THRU ALL; R. N. broj:; Mehatronika i robotika

Datum | Ime i prezime | Potpis | FSB Zagreb FSB Zagreb Strojarstvo
Projektirao | | Vid Pavlović
Razradio | | Vid Pavlović
Crtao | | Vid Pavlović
Pregledao | | Željko Šitum
Voditelj rada | | Željko Šitum
Objekt: Objekt: Plocica alata | | | Objekt broj:

Materijal: Materijal: DX51D+Z275 | Masa(g): | DIPLOMSKI RAD

Naziv: Naziv: 2-VP-DIP-00-01-04-01-001 | Pozicija: | Format: Format: A4

Design by CADLab

Mjerilo originala | | | | Listova: Listova: 1
2-VP-DIP-00-01-04-01-001 1:2 Crtež broj: Crtež broj: | | List: List: 1
