VidPavlovic/Diplomski/Tehnicki_crtezi/2-VP-DIP-00-01-04-02-00.pdf

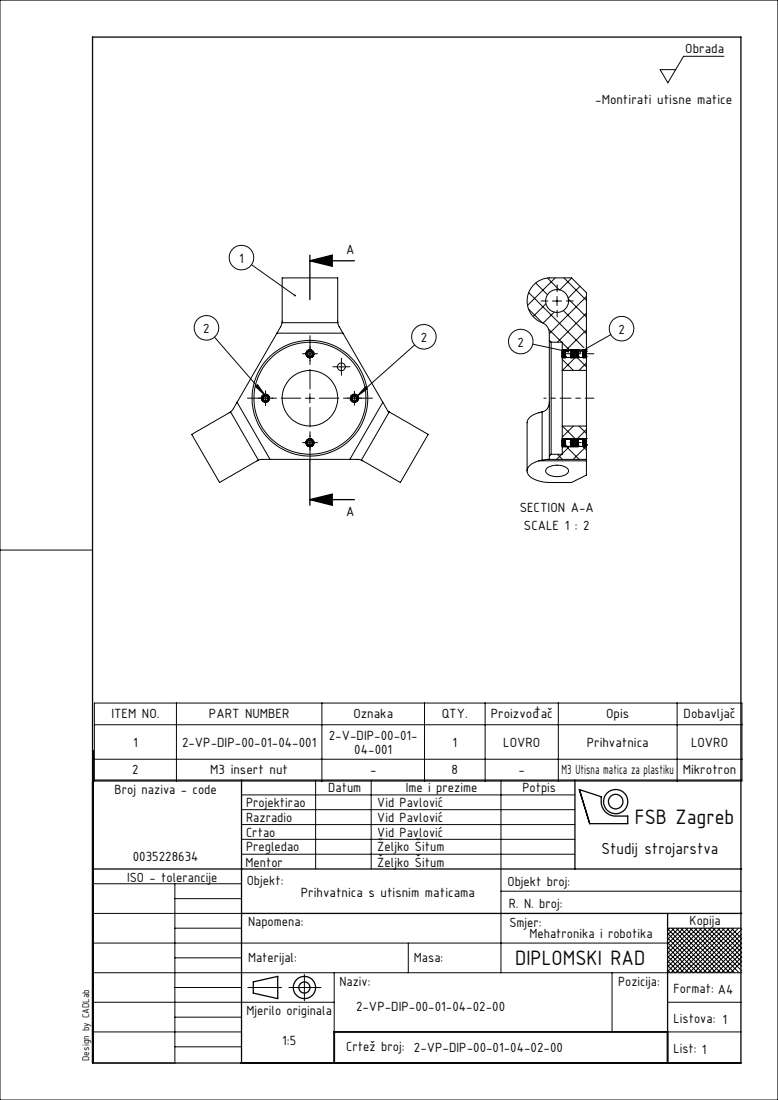
[picture p20: page 1]
SECTION A-A SCALE 1 : 2; Mehatronika i robotika; R. N. broj:

-Montirati utisne matice

ITEM NO. | PART NUMBER | Oznaka | QTY. | Proizvođač | Opis | Dobavljač
1 | 2-VP-DIP-00-01-04-001 | 2-V-DIP-00-01-04-001 | 1 | LOVRO | Prihvatnica | LOVRO

2 | M3 insert nut | - | 8 | - | M3 Utisna matica za plastiku | Mikrotron
Broj naziva - code 0035228634 | | Datum | Ime i prezime | Potpis | Studij strojarstva

Projektirao | | Vid Pavlović
Razradio | | Vid Pavlović | | FSB Zagreb Crtao

Vid Pavlović

Pregledao | | Željko Šitum

Mentor | | Željko Šitum
ISO - tolerancije | Objekt: Prihvatnica s utisnim maticama | | | Objekt broj:

Materijal: | Masa: | DIPLOMSKI RAD

Naziv: 2-VP-DIP-00-01-04-02-00 | Pozicija: | Format: A4

Design by CADLab

Mjerilo originala | | | | Listova: 1
2-VP-DIP-00-01-04-02-00 1:5 Crtež broj: | | List: 1
