VidPavlovic/Diplomski/Tehnicki_crtezi/2-VP-DIP-00-01-04-02-001.pdf

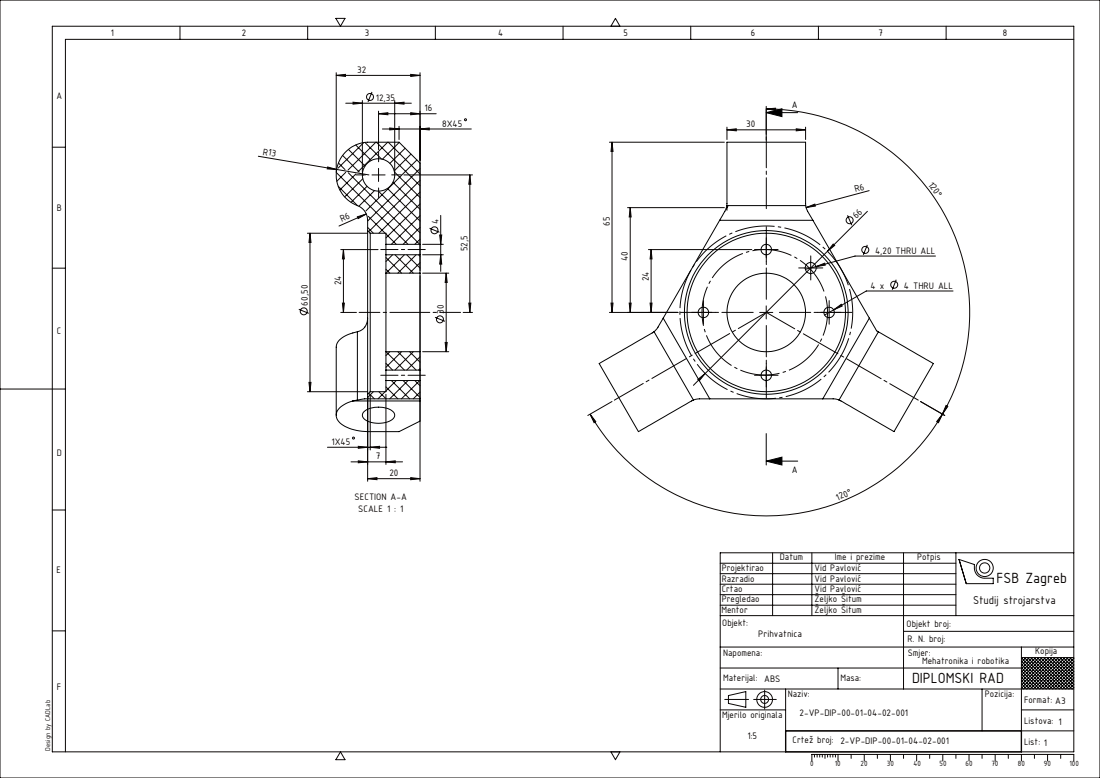
[picture p21: page 1]
4 THRU ALL; 4,20 THRU ALL; SECTION A-A SCALE 1 : 1; Crtež broj:; Datum; Ime i prezime; Razradio; FSB Zagreb; R. N. broj:; Objekt broj:; Mjerilo originala; Studij strojarstva; DIPLOMSKI RAD; Mehatronika i robotika; Vid Pavlović Vid Pavlović Vid Pavlović Željko Šitum Željko Šitum

Design by CADLab
