VidPavlovic/Diplomski/Tehnicki_crtezi/2-VP-DIP-00-02-00.pdf

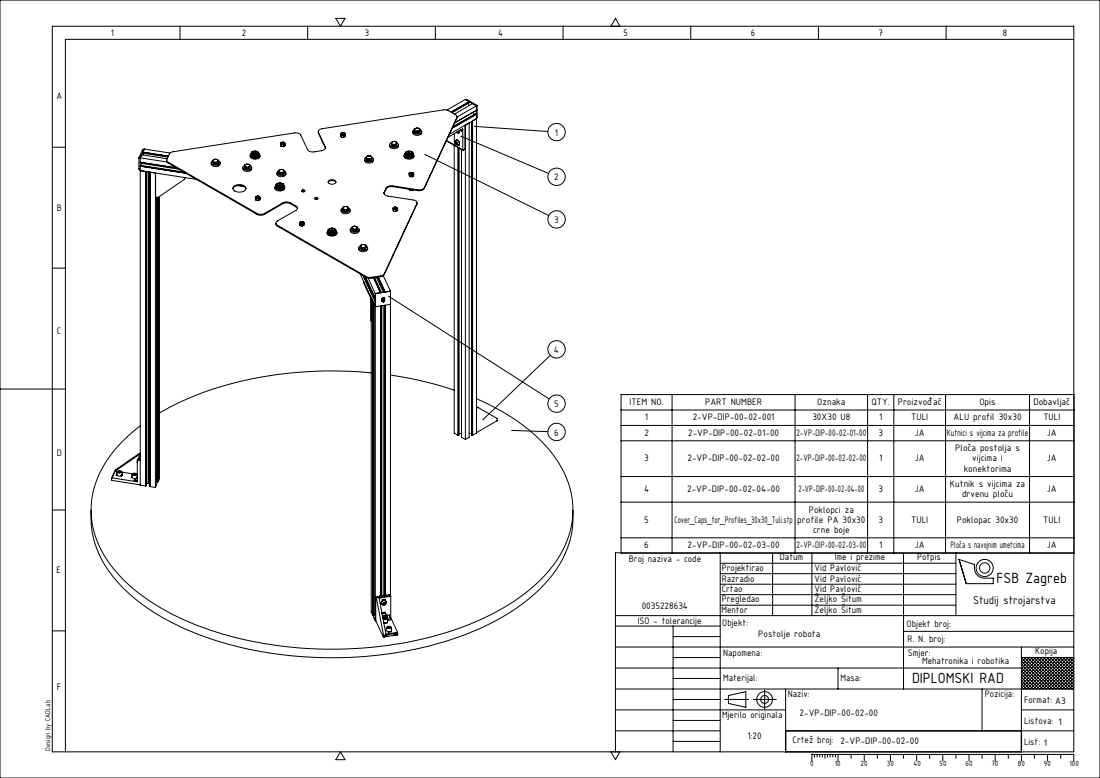
[picture p22: page 1]
Crtež broj:; Datum; Ime i prezime; Razradio; FSB Zagreb; Studij strojarstva; Vid Pavlović Vid Pavlović Vid Pavlović Željko Šitum Željko Šitum 0035228634

ITEM NO. | 2-VP-DIP-00-02-02-00 2-VP-DIP-00-02-01-00 2-VP-DIP-00-02-001 PART NUMBER | 2-VP-DIP-00-02-02-00 2-VP-DIP-00-02-01-00 30X30 U8 Oznaka | QTY. 3 1 1 | Proizvođač TULI JA JA | Kutnici s vijcima za profile ALU profil 30x30 Opis | Dobavljač 1 TULI 2 JA 3

Ploča postolja s vijcima i konektorima | JA

4 | 2-VP-DIP-00-02-04-00 | 2-VP-DIP-00-02-04-00 | 3 | JA | Kutnik s vijcima za drvenu ploču | JA

5 | Cover_Caps_for_Profiles_30x30_Tuli.stp | Poklopci za profile PA 30x30 crne boje | 3 | TULI | Poklopac 30x30 | TULI

6 | 2-VP-DIP-00-02-03-00 | 2-VP-DIP-00-02-03-00 | 1 | JA | Ploča s navojnim umetcima | JA

Broj naziva - code

ISO - tolerancije | Objekt: Objekt broj: Postolje robota R. N. broj:

Napomena: Smjer: Mehatronika i robotika DIPLOMSKI RAD Materijal: Masa: Naziv: Pozicija: 2-VP-DIP-00-02-00 Mjerilo originala | Kopija Format: A31 Listova: List: 1

Design by CADLab
