VidPavlovic/Diplomski/Tehnicki_crtezi/2-VP-DIP-00-02-001.pdf

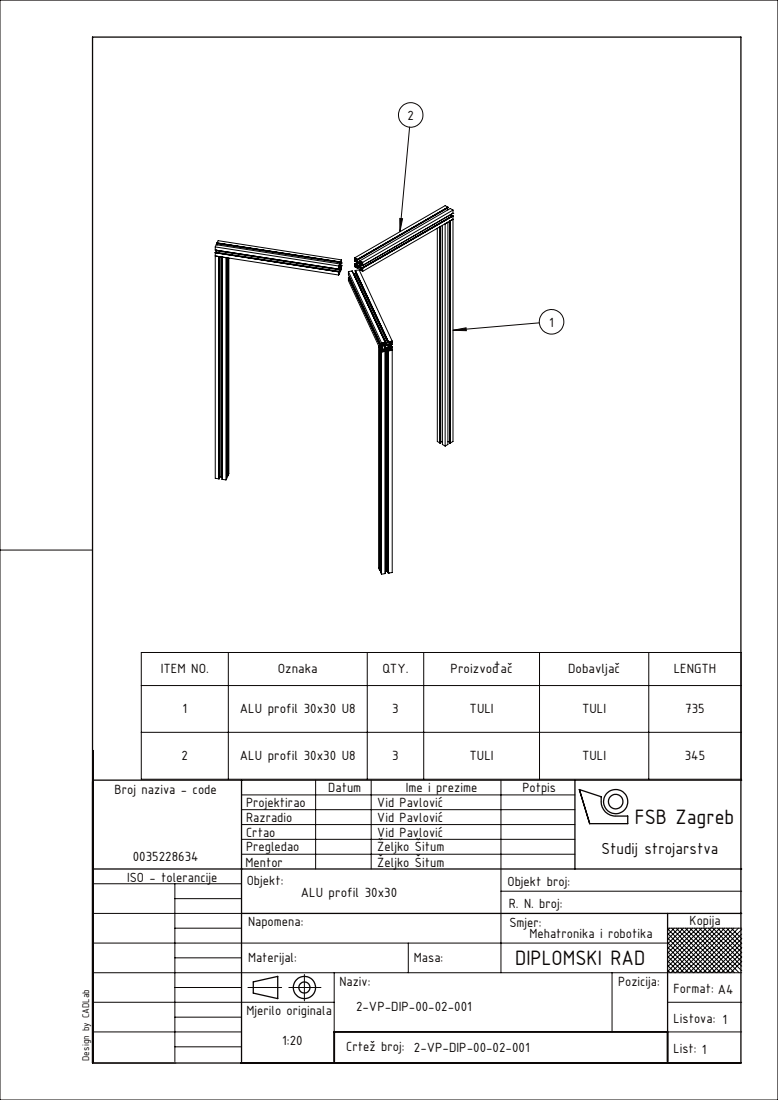
[picture p23: page 1]
Mehatronika i robotika; R. N. broj:

ITEM NO. | Oznaka | QTY. | Proizvođač | Dobavljač | LENGTH

1 | ALU profil 30x30 U8 | 3 | TULI | TULI | 735

2 | ALU profil 30x30 U8 | 3 | TULI | TULI | 345

Broj naziva - code 0035228634 | | Datum | Ime i prezime | Potpis | Studij strojarstva

Projektirao | | Vid Pavlović
Razradio | | Vid Pavlović | | FSB Zagreb Crtao

Vid Pavlović

Pregledao | | Željko Šitum

Mentor | | Željko Šitum
ISO - tolerancije | Objekt: ALU profil 30x30 | | | Objekt broj:

Materijal: | Masa: | DIPLOMSKI RAD

Naziv: 2-VP-DIP-00-02-001 | Pozicija: | Format: A4

Design by CADLab

Mjerilo originala | | | | Listova: 1
2-VP-DIP-00-02-001 1:20 Crtež broj: | | List: 1
