VidPavlovic/Diplomski/Tehnicki_crtezi/2-VP-DIP-00-02-01-00.pdf

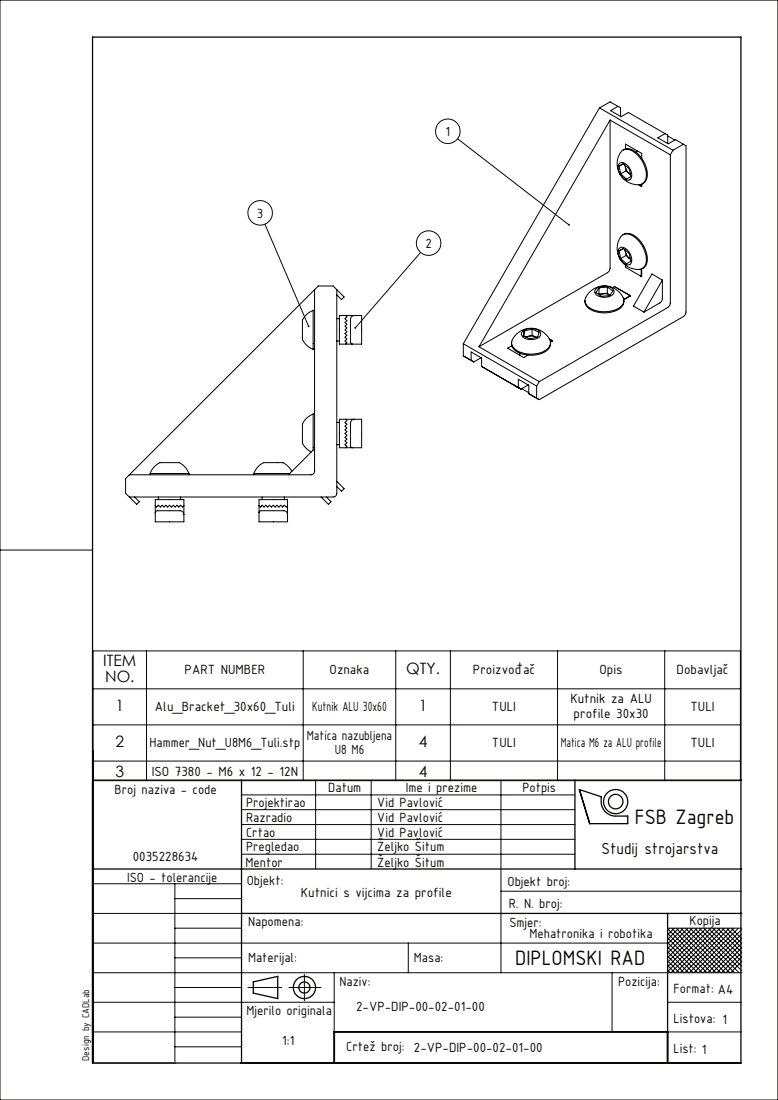
[picture p24: page 1]
Mehatronika i robotika; R. N. broj:

ITEM NO. | PART NUMBER | Oznaka | QTY. | Proizvođač | Opis | Dobavljač

1 | Alu_Bracket_30x60_Tuli | Kutnik ALU 30x60 | 1 | TULI | Kutnik za ALU profile 30x30 | TULI

2 | Hammer_Nut_U8M6_Tuli.stp | Matica nazubljena U8 M6 | 4 | TULI | Matica M6 za ALU profile | TULI

3 | ISO 7380 - M6 x 12 - 12N | | 4
Broj naziva - code 0035228634 | | Datum | Ime i prezime | Potpis | Studij strojarstva

Projektirao | | Vid Pavlović
Razradio | | Vid Pavlović | | FSB Zagreb Crtao

Vid Pavlović

Pregledao | | Željko Šitum

Mentor | | Željko Šitum
ISO - tolerancije | Objekt: Kutnici s vijcima za profile | | | Objekt broj:

Materijal: | Masa: | DIPLOMSKI RAD

Naziv: 2-VP-DIP-00-02-01-00 | Pozicija: | Format: A4

Design by CADLab

Mjerilo originala | | | | Listova: 1
2-VP-DIP-00-02-01-00 1:1 Crtež broj: | | List: 1
