VidPavlovic/Diplomski/Tehnicki_crtezi/2-VP-DIP-00-02-02-001.pdf

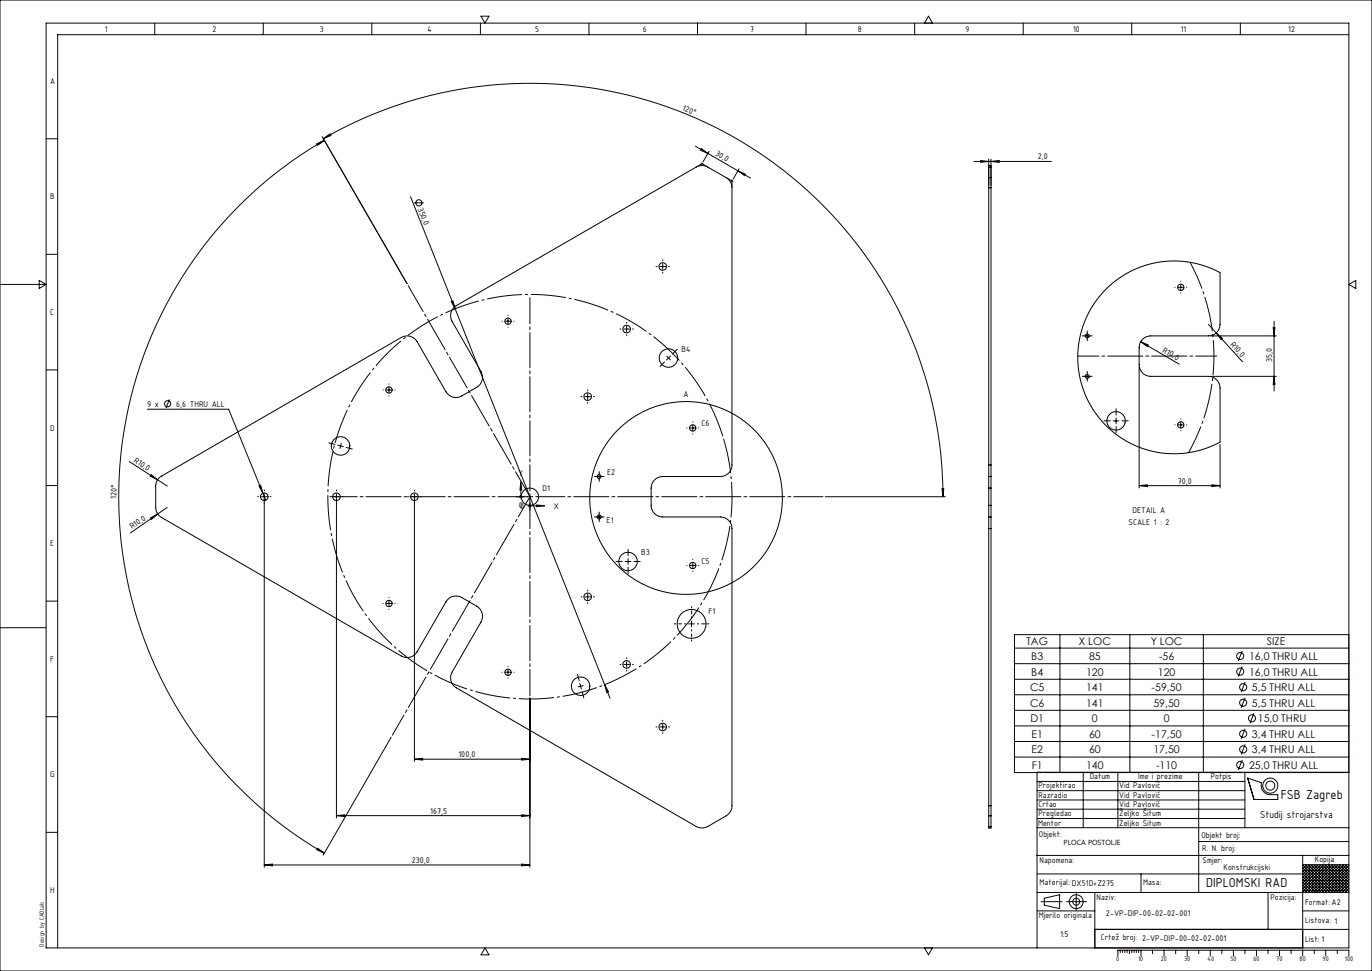
[picture p25: page 1]
6,6 THRU ALL; DETAIL A SCALE 1 : 2; PLOCA POSTOLJE; Crtež broj:; R. N. broj:; Objekt broj:; Mjerilo originala; DIPLOMSKI RAD

TAG | X LOC | Y LOC | SIZE
B3 | 85 | -56 | 16,0 THRU ALL
B4 | 120 | 120 | 16,0 THRU ALL
C5 | 141 | -59,50 | 5,5 THRU ALL
C6 | 141 | 59,50 | 5,5 THRU ALL
D1 | 0 | 0 | 15,0 THRU
E1 | 60 | -17,50 | 3,4 THRU ALL
E2 | 60 | 17,50 | 3,4 THRU ALL
F1 | 140 | -110 | 25,0 THRU ALL
Datum Ime i prezime Potpis Projektirao Vid Pavlović Razradio Vid Pavlović Crtao Vid Pavlović Pregledao Željko Šitum Mentor Željko Šitum | FSB Zagreb Studij strojarstva

Design by CADLab
