VidPavlovic/Diplomski/Tehnicki_crtezi/2-VP-DIP-00-02-03-00.pdf

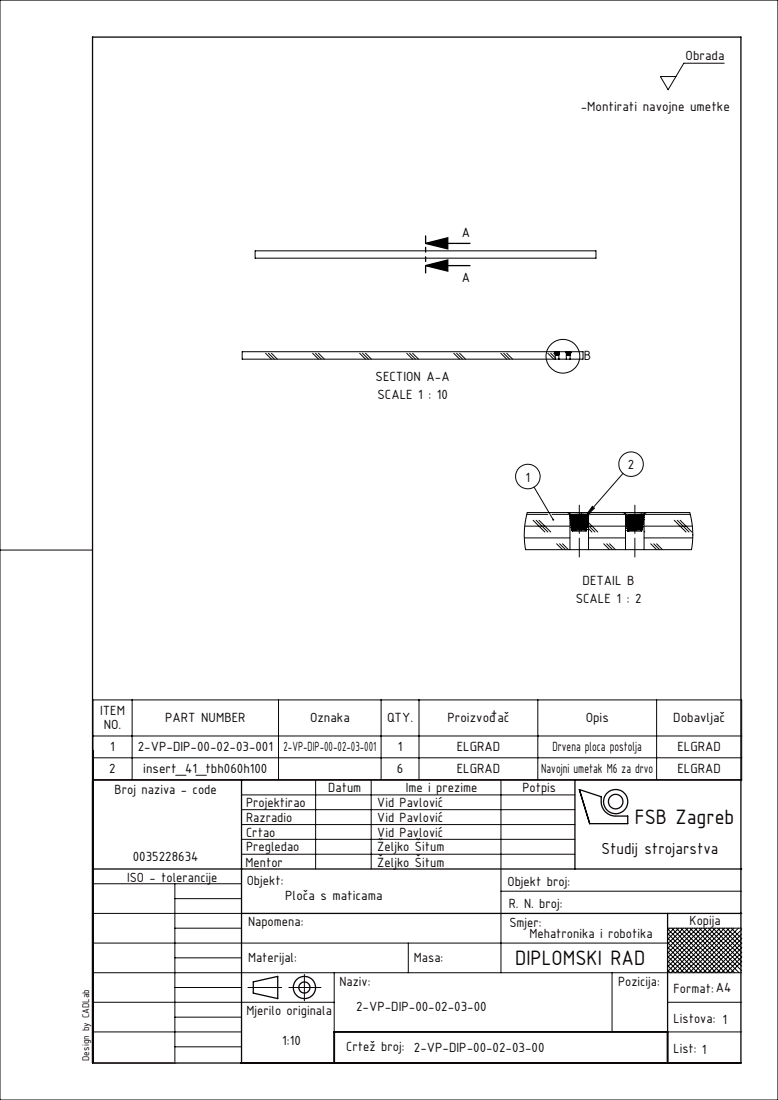
[picture p26: page 1]
SECTION A-A SCALE 1 : 10; DETAIL B SCALE 1 : 2; Mehatronika i robotika; R. N. broj:

-Montirati navojne umetke

ITEM NO. | PART NUMBER | Oznaka | QTY. | Proizvođač | Opis | Dobavljač

1 | 2-VP-DIP-00-02-03-001 | 2-VP-DIP-00-02-03-001 | 1 | ELGRAD | Drvena ploca postolja | ELGRAD
2 | insert_41_tbh060h100 | | 6 | ELGRAD | Navojni umetak M6 za drvo | ELGRAD
Broj naziva - code 0035228634 | | Datum | Ime i prezime | Potpis | Studij strojarstva

Projektirao | | Vid Pavlović
Razradio | | Vid Pavlović | | FSB Zagreb Crtao

Vid Pavlović

Pregledao | | Željko Šitum

Mentor | | Željko Šitum
ISO - tolerancije | Objekt: Ploča s maticama | | | Objekt broj:

Materijal: | Masa: | DIPLOMSKI RAD

Naziv: 2-VP-DIP-00-02-03-00 | Pozicija: | Format: A4

Design by CADLab

Mjerilo originala | | | | Listova: 1
2-VP-DIP-00-02-03-00 1:10 Crtež broj: | | List: 1
