VidPavlovic/Diplomski/Tehnicki_crtezi/2-VP-DIP-00-02-03-001.pdf

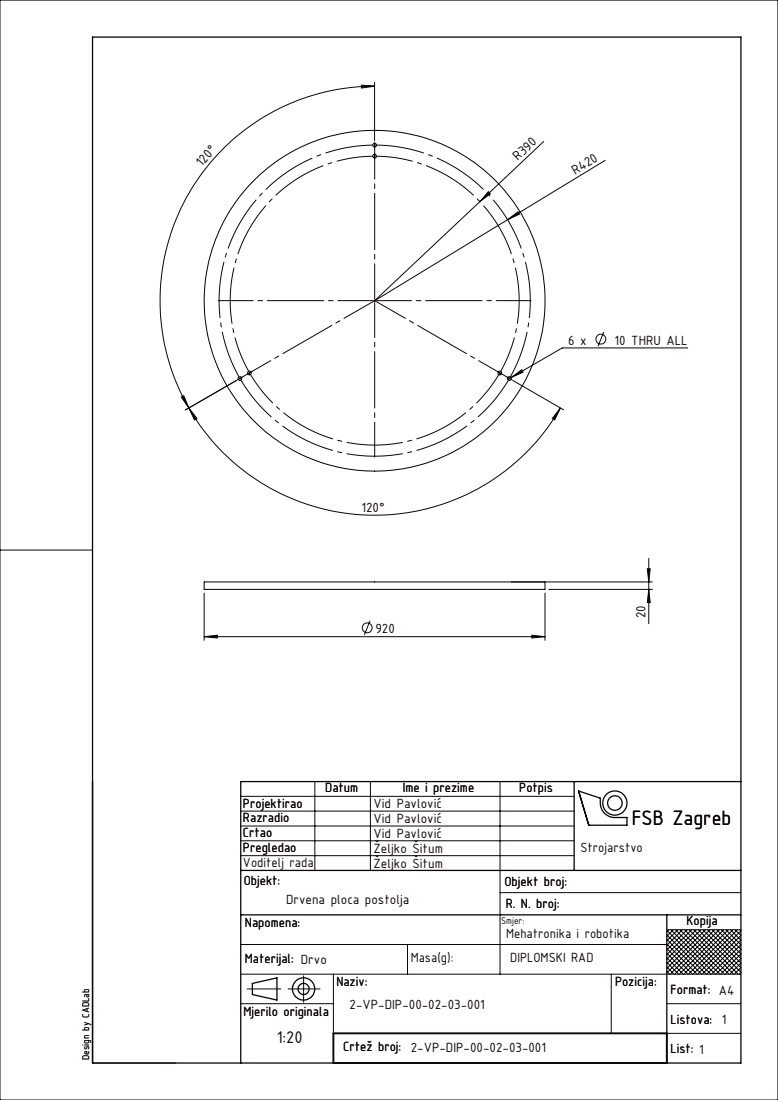
[picture p27: page 1]
10 THRU ALL; R. N. broj:; Mehatronika i robotika

Datum | Ime i prezime | Potpis | FSB Zagreb FSB Zagreb Strojarstvo
Projektirao | | Vid Pavlović
Razradio | | Vid Pavlović
Crtao | | Vid Pavlović
Pregledao | | Željko Šitum
Voditelj rada | | Željko Šitum
Objekt: Objekt: Drvena ploca postolja | | | Objekt broj:

Materijal: Materijal: Drvo | Masa(g): | DIPLOMSKI RAD

Naziv: Naziv: 2-VP-DIP-00-02-03-001 | Pozicija: | Format: Format: A4

Design by CADLab

Mjerilo originala | | | | Listova: Listova: 1
2-VP-DIP-00-02-03-001 1:20 Crtež broj: Crtež broj: | | List: List: 1
