VidPavlovic/Diplomski/Tehnicki_crtezi/2-VP-DIP-00-02-04-00.pdf

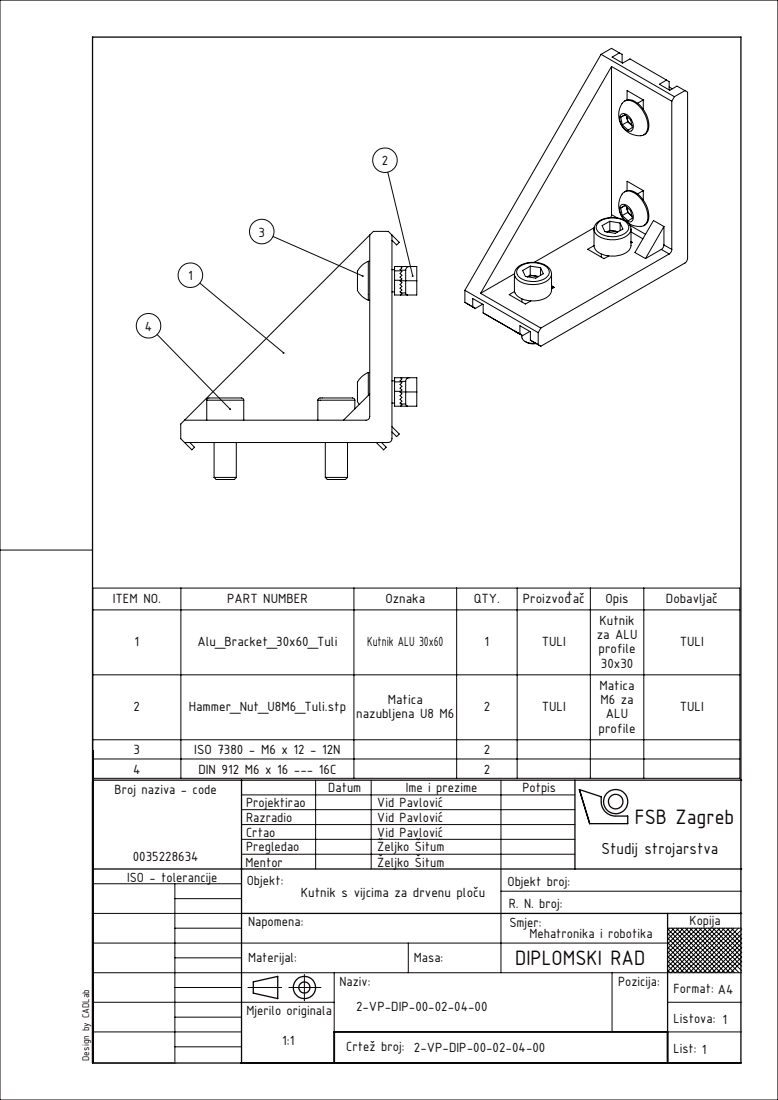
[picture p28: page 1]
Mehatronika i robotika; R. N. broj:

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

2 | Hammer_Nut_U8M6_Tuli.stp | Matica nazubljena U8 M6 | 2 | TULI | Matica M6 za ALU profile | TULI

3 | ISO 7380 - M6 x 12 - 12N | | 2
4 | DIN 912 M6 x 16 --- 16C | | 2
Broj naziva - code 0035228634 | | Datum | Ime i prezime | Potpis | Studij strojarstva

Projektirao | | Vid Pavlović
Razradio | | Vid Pavlović | | FSB Zagreb Crtao

Vid Pavlović

Pregledao | | Željko Šitum

Mentor | | Željko Šitum
ISO - tolerancije | Objekt: Kutnik s vijcima za drvenu ploču | | | Objekt broj:

Materijal: | Masa: | DIPLOMSKI RAD

Naziv: 2-VP-DIP-00-02-04-00 | Pozicija: | Format: A4

Design by CADLab

Mjerilo originala | | | | Listova: 1
2-VP-DIP-00-02-04-00 1:1 Crtež broj: | | List: 1
