VidPavlovic/Diplomski/Tehnicki_crtezi/2-VP-DIP-00.pdf

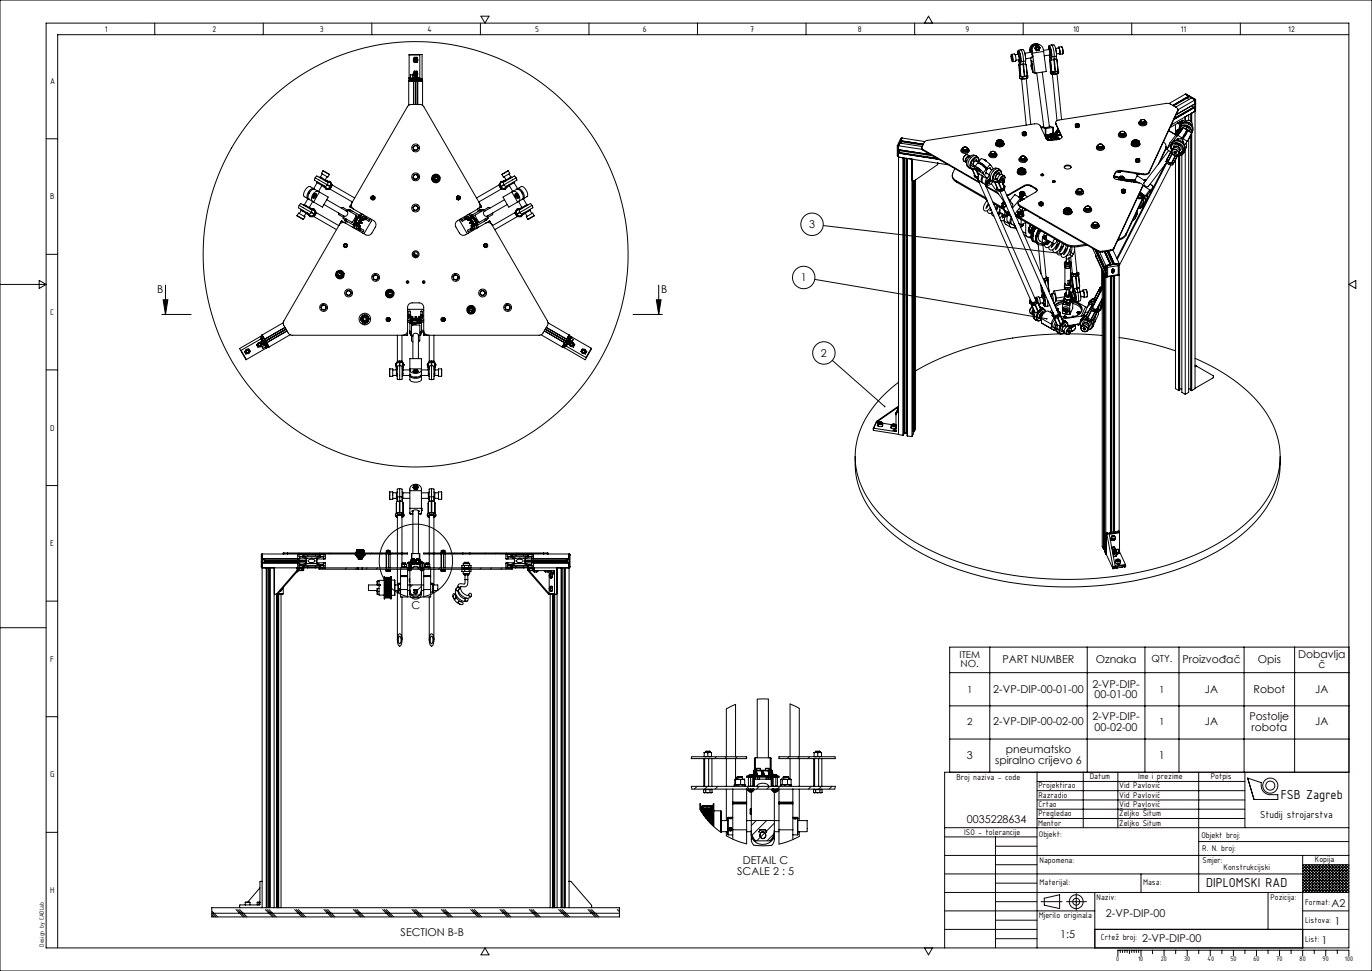
[picture p29: page 1]
SECTION B-B; DETAIL C SCALE 2 : 5; Crtež broj:; Mjerilo originala; DIPLOMSKI RAD

NO. ITEM | PART NUMBER | Oznaka | QTY. | Proizvođač | Opis | Dobavlja č

1 | 2-VP-DIP-00-01-00 | 2-VP-DIP-00-01-00 | 1 | JA | Robot | JA

2 | 2-VP-DIP-00-02-00 | 2-VP-DIP-00-02-00 | 1 | JA | Postolje robota | JA

3 | pneumatsko spiralno crijevo 6 | | 1

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

ISO - tolerancije | Objekt: Objekt broj: R. N. broj:

Design by CADLab
