VidPavlovic/Diplomski/Elektronicka_shema/2-VP-DIP-02.pdf

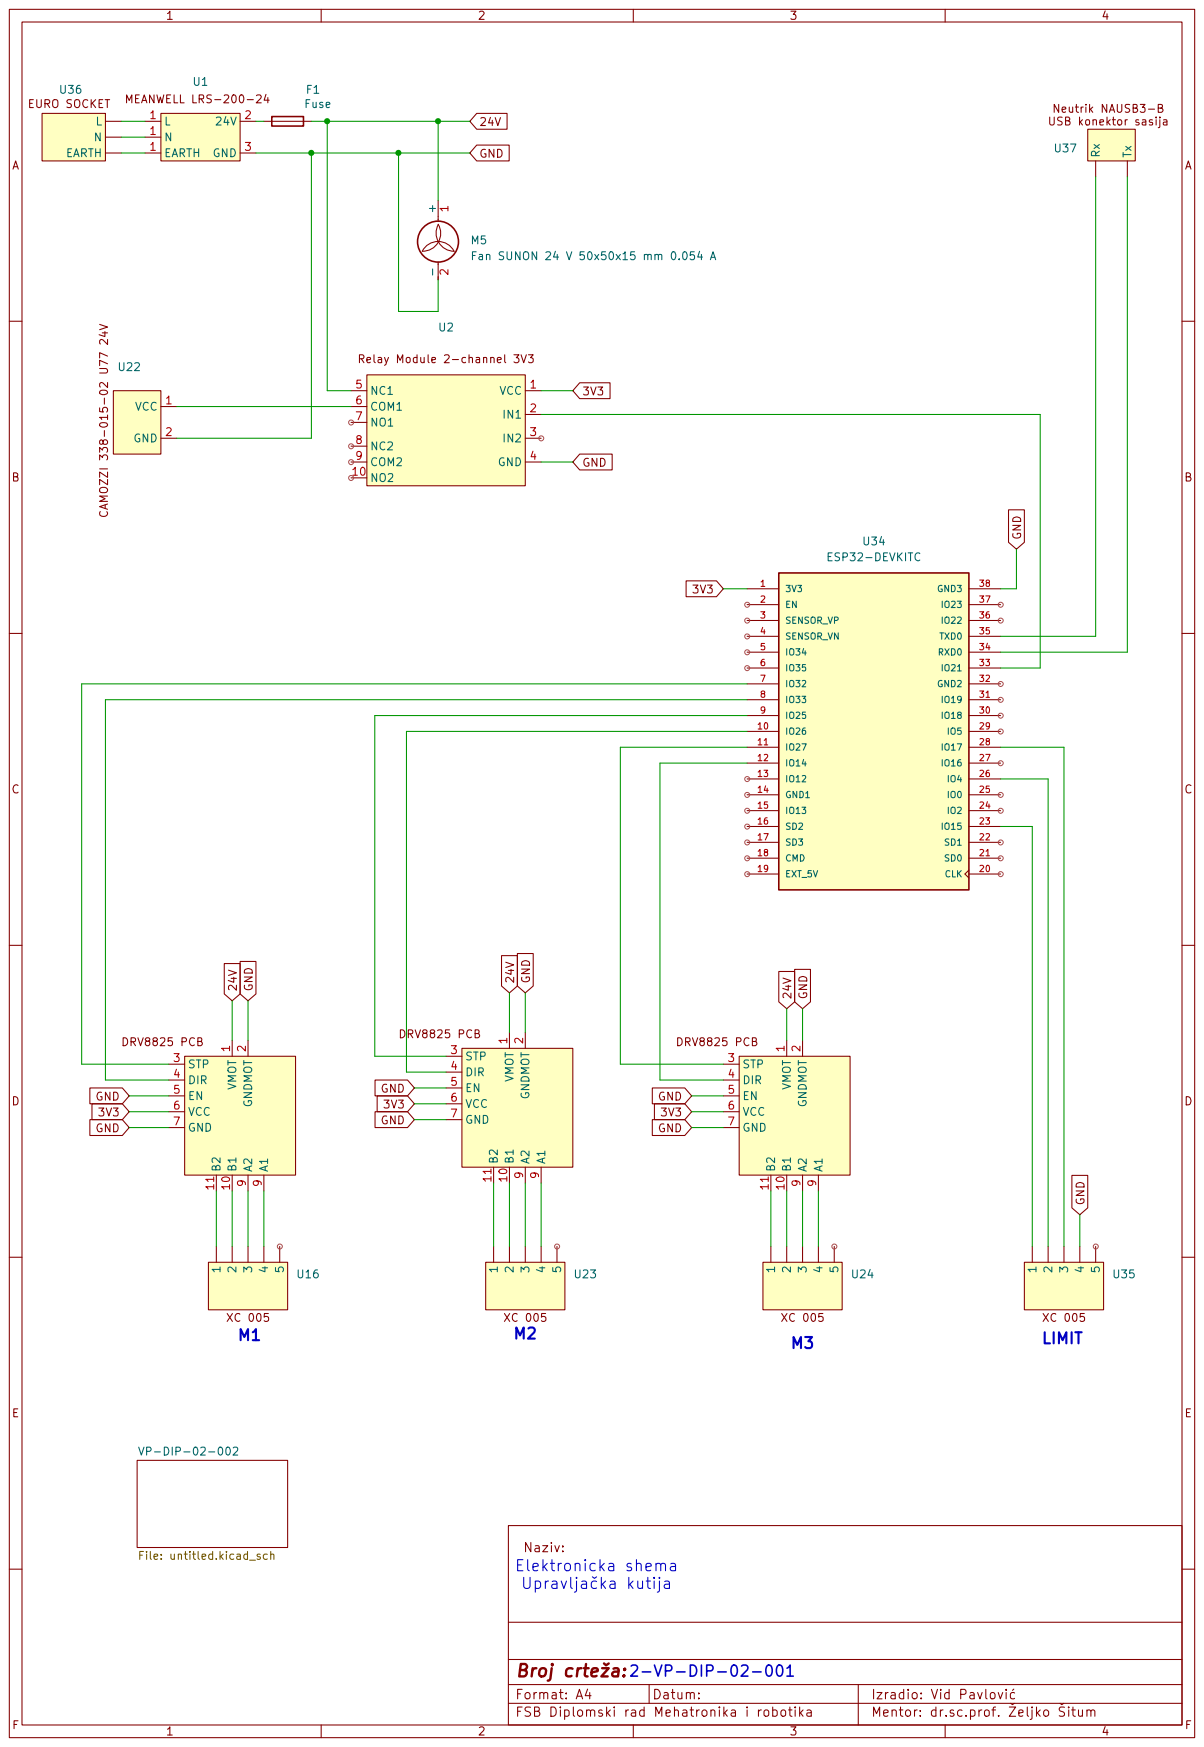
[picture p30: page 1]

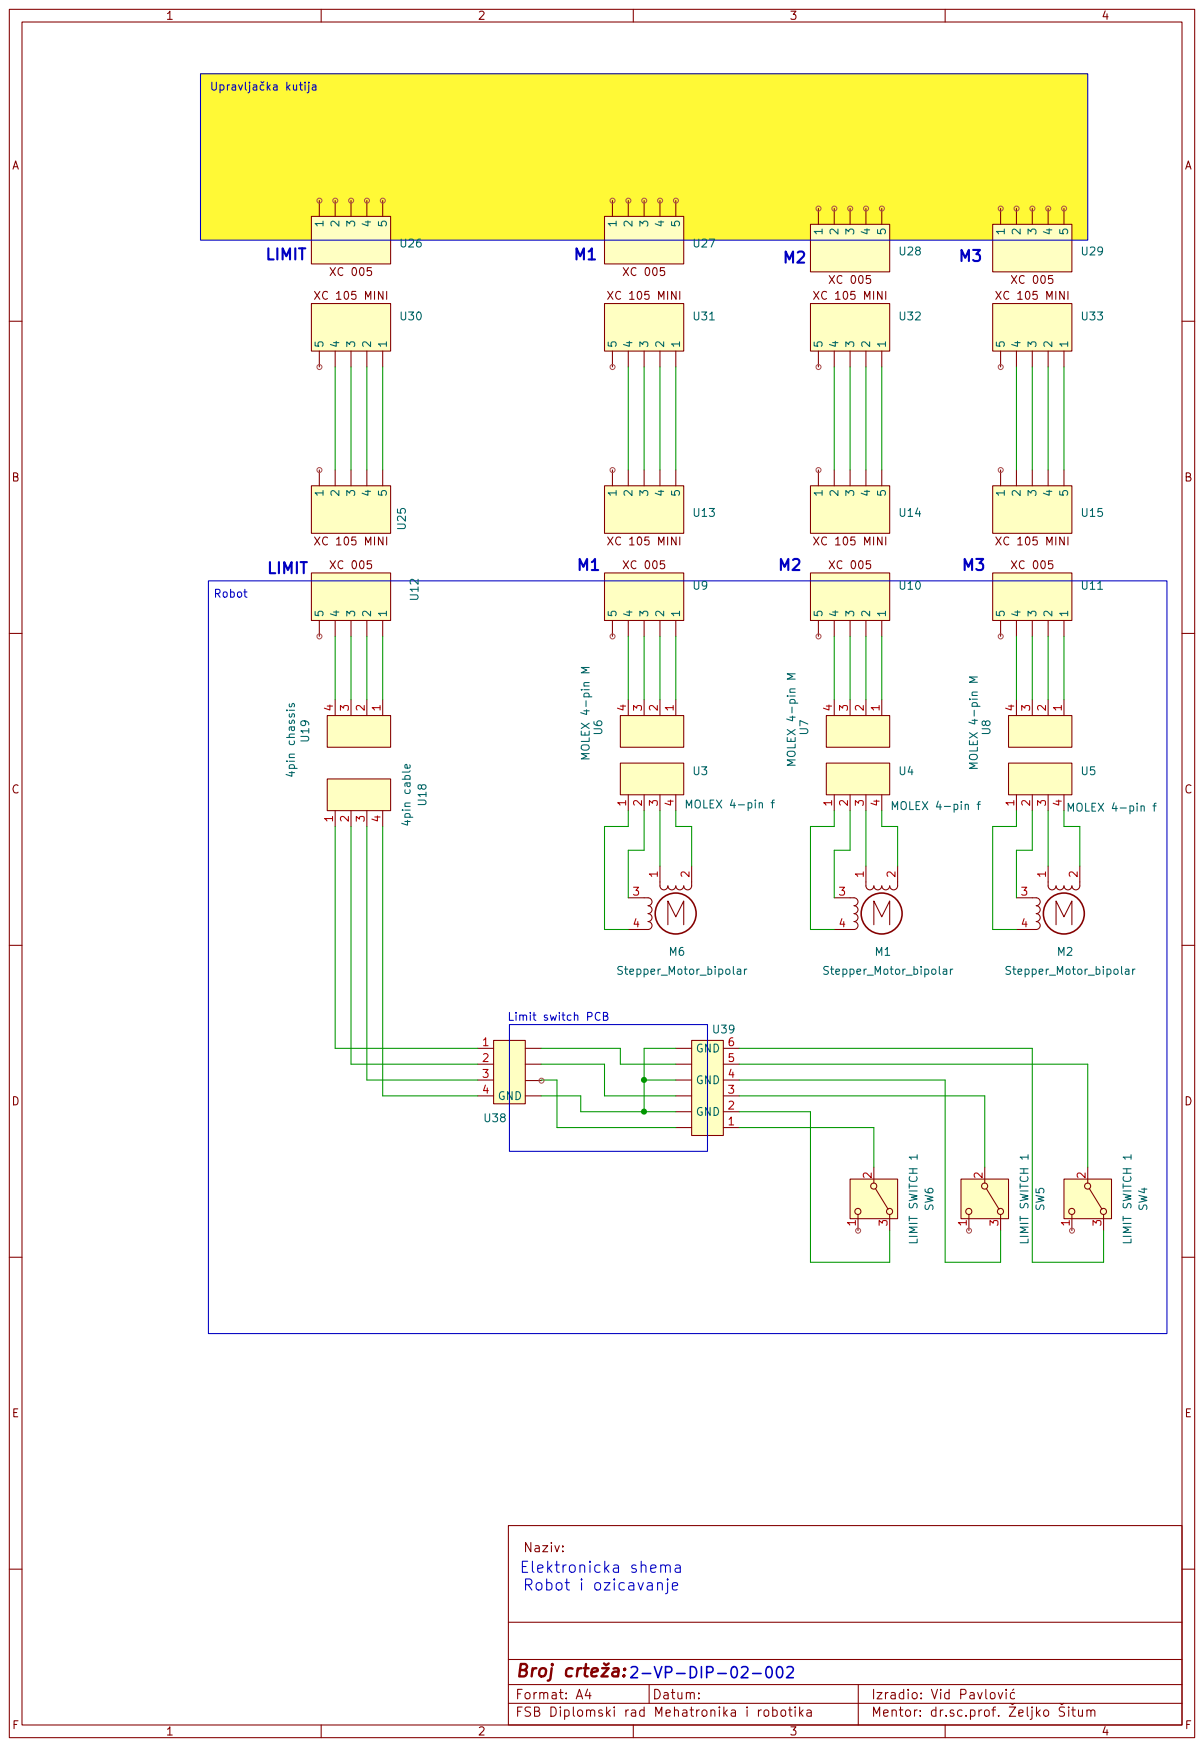
[picture p31: page 2]
